MLeggiero/taxelscan/boards/rev4/fab/STACKUP-NOTES.txt

Stackup the design assumes

  4 layer, 1.6 mm finished thickness
  F.Cu / B.Cu   1 oz (35 um)
  In1.Cu        0.5 oz (17.5 um)   GND plane
  In2.Cu        0.5 oz (17.5 um)   +3.3V plane (no signal routing)

The 5 V rails (+5V_BUS, +5V_USB) run only on the 1 oz outer layers,
0.30 mm wide (USB_BUS_SW 0.40 mm): about 1 A at a 10 C rise against
the 0.7 A the chain can draw at the switch's high current limit.
Nothing on In2 carries 5 V, so 0.5 oz inner copper is enough; 1 oz
inner layers are margin, not a problem.

Vias are 0.3 mm drill / 0.5 or 0.6 mm pad: a 0.10 mm annular ring,
inside JLCPCB's via rule (pad >= hole + 0.10 mm) at no extra cost.

The vias are tented: solder mask covers each one on both sides, except
where it sits in a pad's opening. No via hole is in an SMD pad's
solder-mask opening, or within 0.10 mm of one (JLCPCB's minimum mask
bridge), except the 9 ground vias in the exposed pads of U9 (7) and
U12 (2), where the RP2350 and TPS62162 layouts put them, under the
paste windows. U5 pin 15's ground via (that mux's enable, tied low) is
boxed in by the column lines at the toe of its pad, so that pad's toe
is cut back 0.30 mm (1.60 mm long, the other pins 1.90): the hole is
0.15 mm clear of it, under the mask, and the lead still lands on the
pad at the package's largest lead span. tools/via_in_pad.py counts
them, and the board rule 'via hole clear of SMD pads' holds the rest
in KiCad's DRC. Until the 21 October design review 98 vias besides the
exposed pads' had their holes in pads, 32 of them on one pad of a
two-pad passive (the tombstoning case), and the board had to be
ordered with epoxy-filled, capped vias (../REVIEW.md).

Epoxy filled and capped vias are now optional (a paid option on a
4-layer board). They keep paste from draining into the exposed-pad
vias, which otherwise leave some voiding under U9 and U12, as any open
thermal via does. Without them, check the exposed pads at inspection.

Copper is at least 0.40 mm from the outline everywhere: JLCPCB's figure
for a V-scored edge (a routed edge needs 0.2 mm).
