MLeggiero/taxelscan/assets/taxelscan-demo.gif

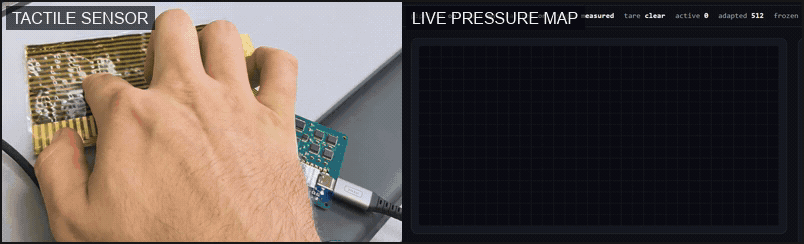
assets/taxelscan-demo.gif
