MLeggiero/taxelscan/assets/taxelscan-v3-bottom.png

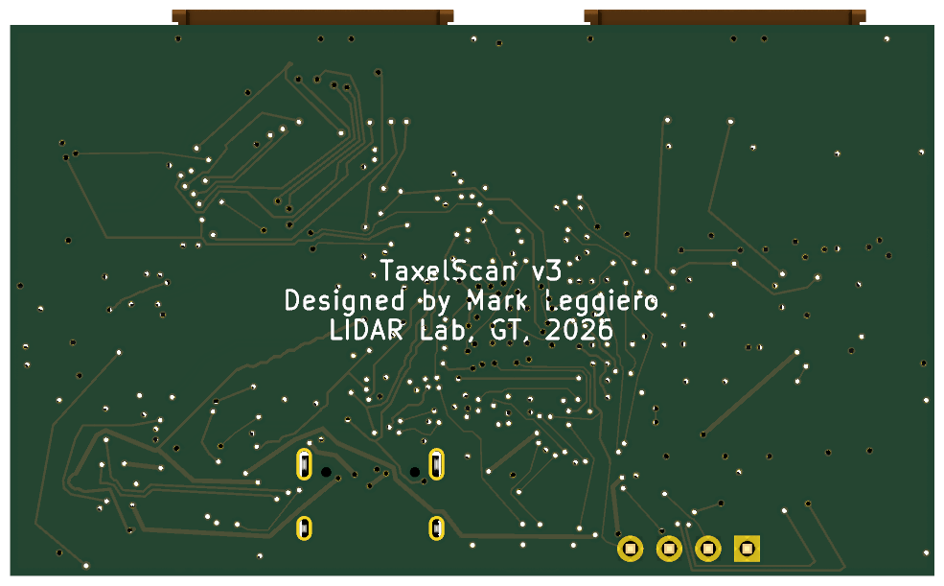
assets/taxelscan-v3-bottom.png
