MLeggiero/taxelscan/assets/taxelscan-v3-top.png

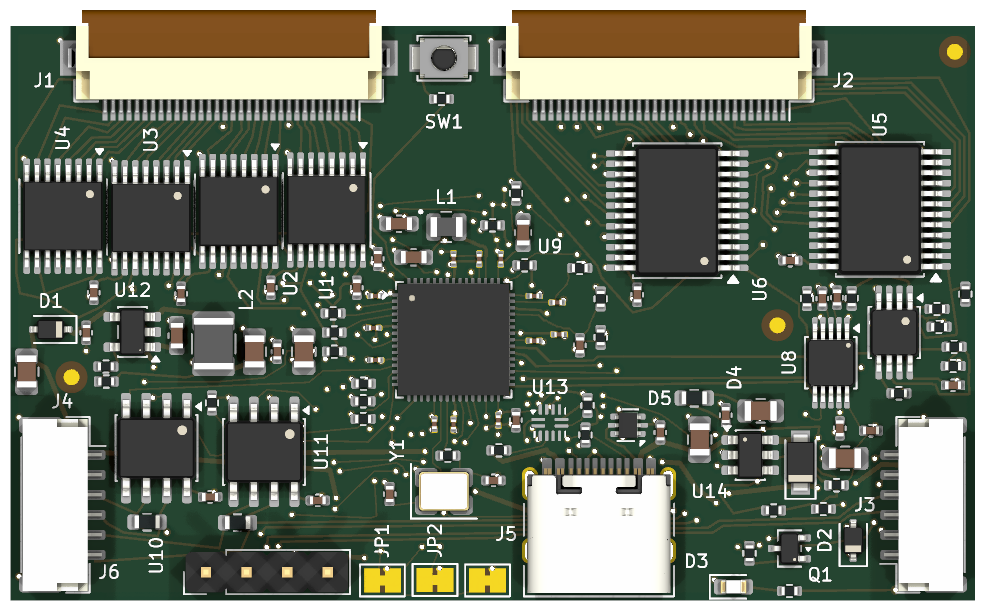
assets/taxelscan-v3-top.png
