MLeggiero/taxelscan/boards/fork-adapter/fork_bottom.png

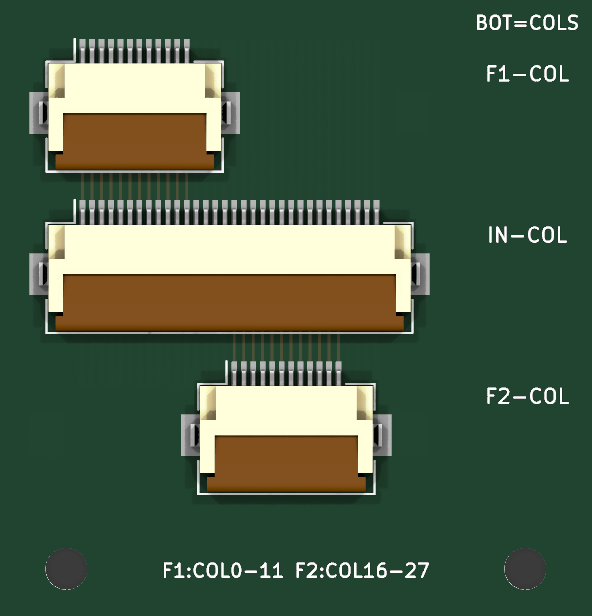
boards/fork-adapter/fork_bottom.png
