MLeggiero/taxelscan/boards/fork-adapter/fork_render.png

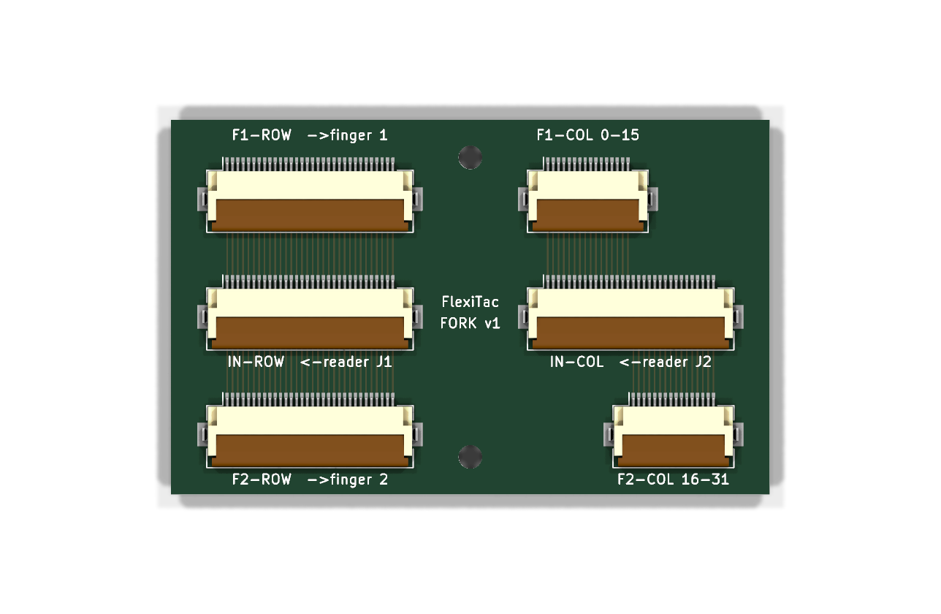
boards/fork-adapter/fork_render.png
