MLeggiero/taxelscan/boards/fork-adapter/fork_top.png

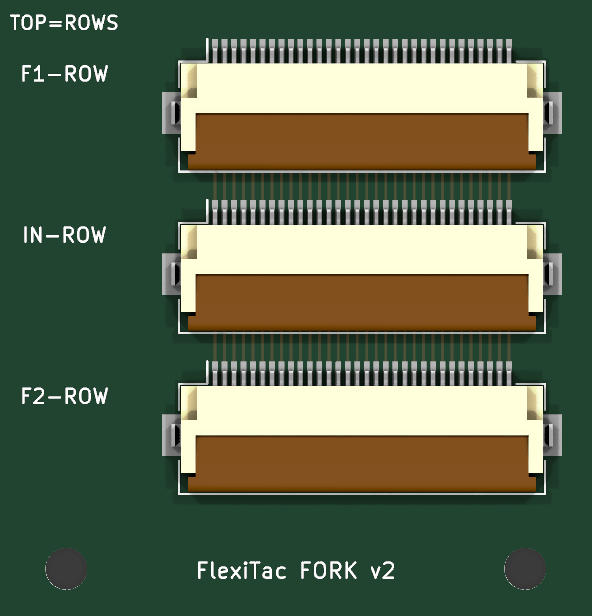
boards/fork-adapter/fork_top.png
