MLeggiero/taxelscan/boards/fork-adapter/fork_v3.png

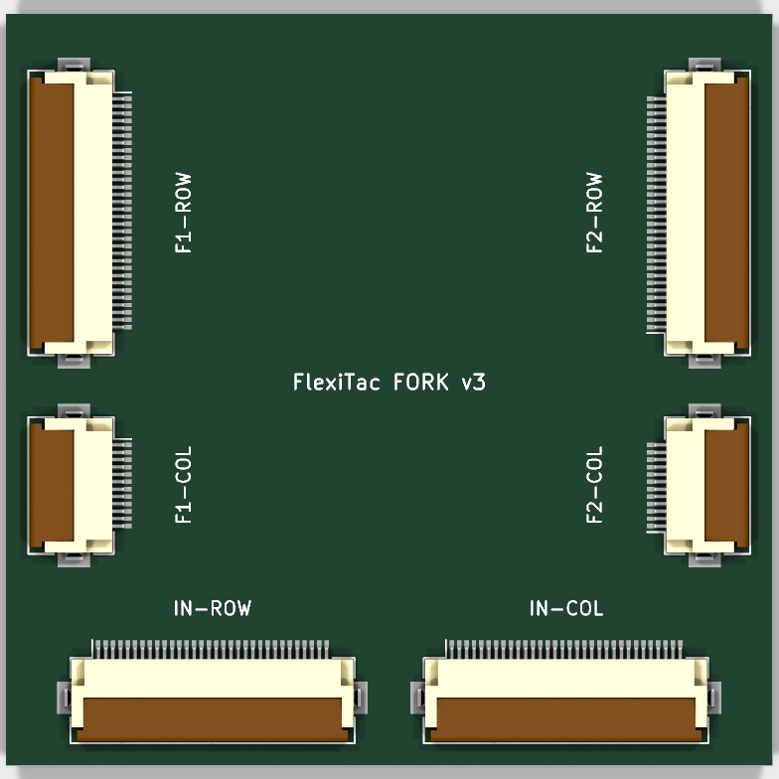
boards/fork-adapter/fork_v3.png
