MLeggiero/taxelscan/boards/fork-adapter/v4_bot.png

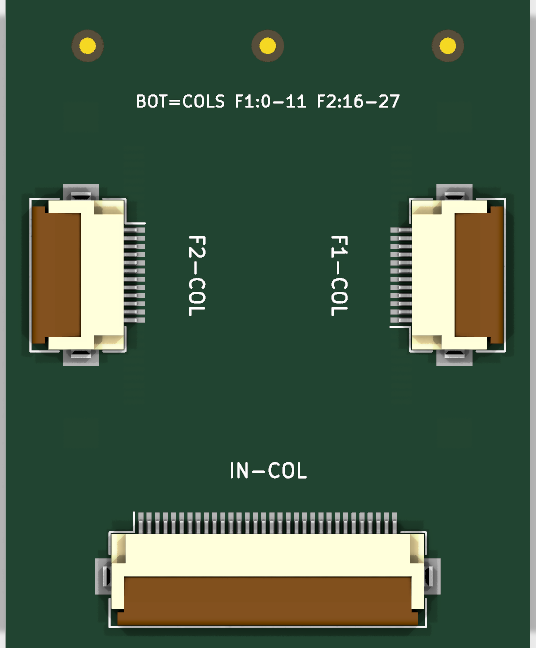
boards/fork-adapter/v4_bot.png
