MLeggiero/taxelscan/boards/fork-adapter/v4_top.png

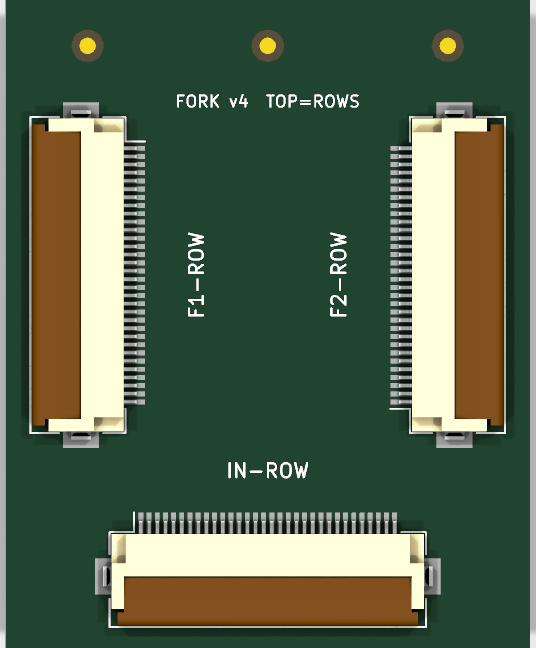
boards/fork-adapter/v4_top.png
