MLeggiero/taxelscan/boards/rev4/pcb_rev3_vs_rev4.png

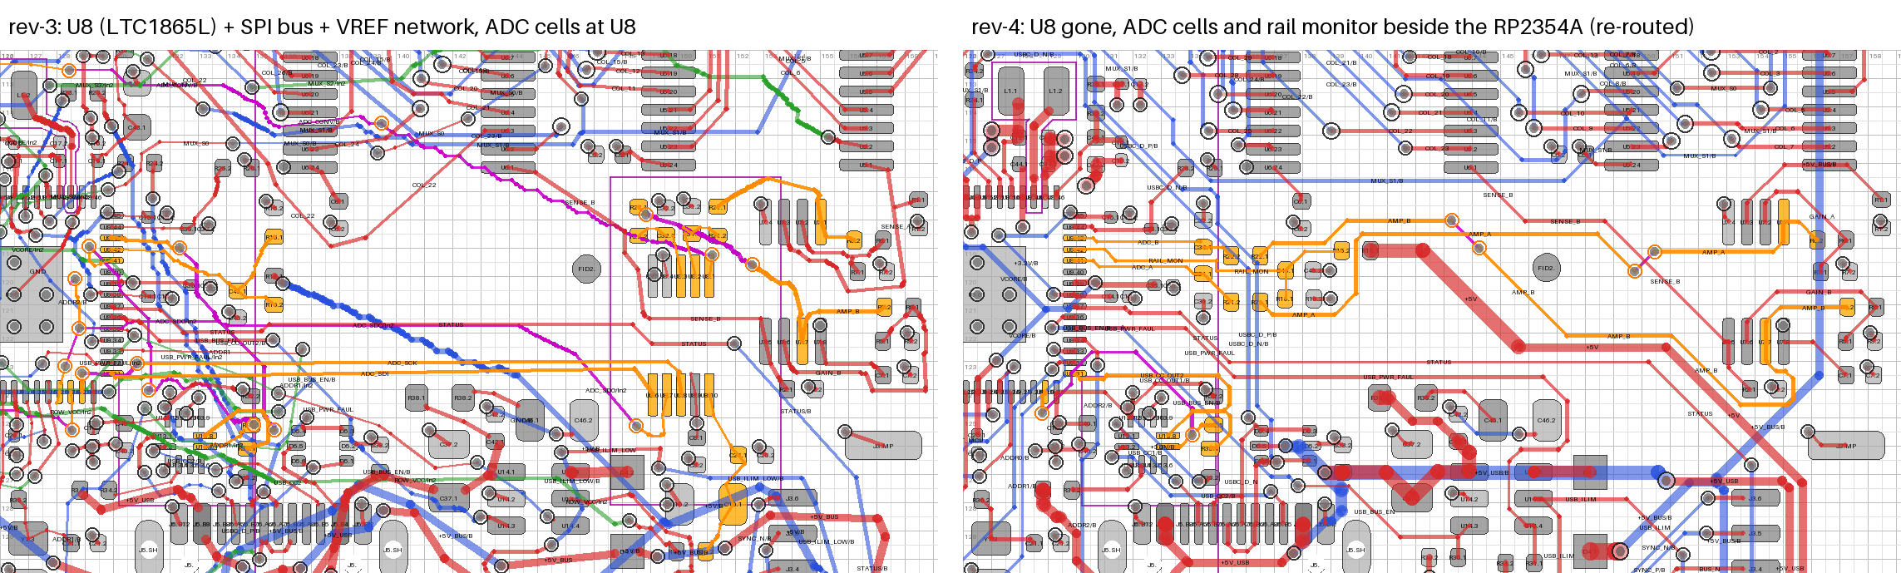
boards/rev4/pcb_rev3_vs_rev4.png
