MLeggiero/taxelscan/boards/rev4/pcb_top.png

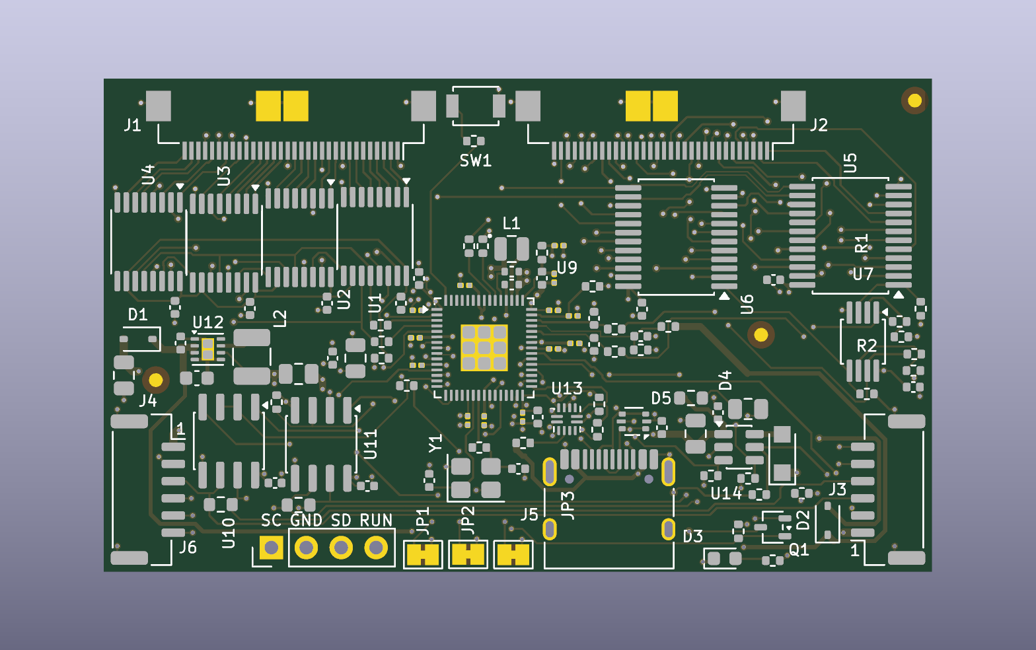
boards/rev4/pcb_top.png
