MLeggiero/taxelscan/boards/v2-module/pcb_top.png

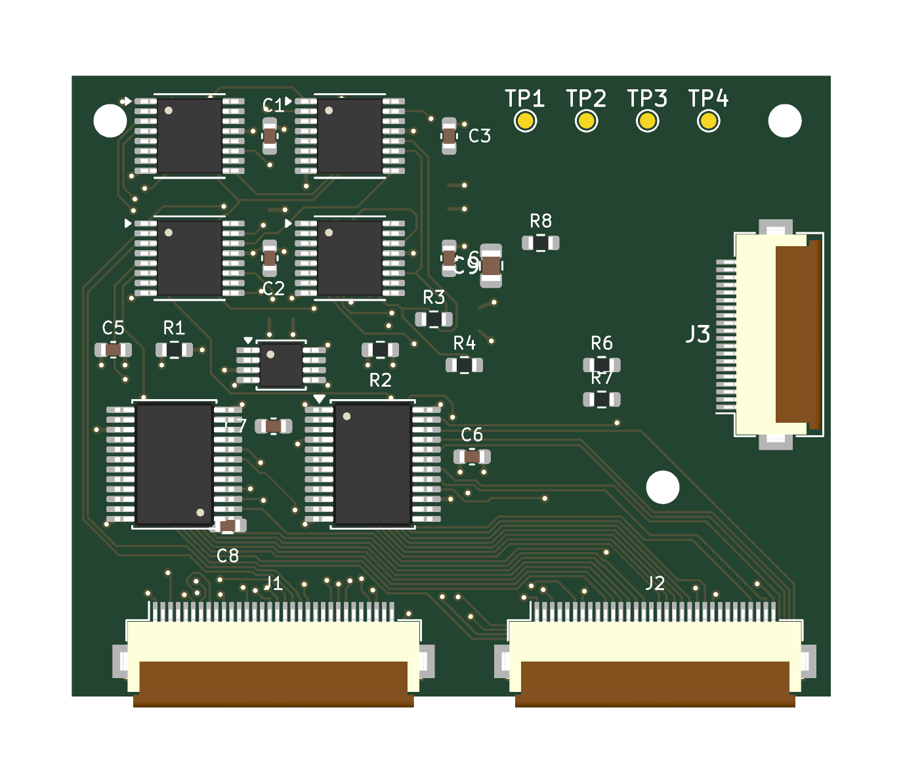
boards/v2-module/pcb_top.png
