MLeggiero/taxelscan/boards/rev4/fab/ORDER-NOTES.txt

JLCPCB order settings for rev-4 (rev-3's, checked 17 September 2026, less U8/C8/R10/C10/C26)

PCB
  Layers 4, thickness 1.6 mm, stackup JLC04161H-7628 (inner 0.5 oz)
  Outer copper 1 oz; via 0.3 mm / 0.45 mm or larger (no surcharge)
  Via Covering: Tented (Epoxy Filled & Capped optional: see STACKUP-NOTES)
  Min trace/space 0.10 mm (above the 3.5 mil surcharge band)

Files
  PCB: rev4-gerbers.zip (Gerbers with Protel extensions, Excellon drills).
  JLCPCB's viewer should show the four copper layers in this order:
    L1 top      rev4-F_Cu.gtl
    L2 ground   rev4-GND.g1   (In1, the GND plane)
    L3 3.3 V    rev4-PWR.g2   (In2, the +3.3V plane)
    L4 bottom   rev4-B_Cu.gbl
  G1 / G2 are Protel's first and second inner layers, and each file
  names its layer in its X2 attributes too. If the viewer has the
  inner layers the other way round, put them right before ordering.

Assembly
  Standard PCBA (0201 parts; Economic stops at 0402), top side only
  Middle boards: rev4-bom.csv + rev4-cpl.csv (no R11/R12)
  The two end boards: rev4-bom-end.csv + rev4-cpl-end.csv
  JLCPCB adds rails; J1/J2 overhang the top edge by 1.5 mm, so expect
  an SMT fixture fee. J6 is through-hole (or leave it for hand fit).

Rotations and positions in the CPLs are already corrected for JLCPCB's
own footprints (jlc_placement.csv, fitted pad by pad by
tools/jlc_placement.py from each LCSC part's EasyEDA footprint):
  turned -90 deg  U1-U4 (TSSOP-16), U5/U6 (SSOP-24), U7 (MSOP-8),
                  U10/U11 (SOIC-8), J6 (pin header, also moved 3.81 mm
                  from pin 1 to its middle)
  turned 180 deg  U14 (SOT-23-6), D5 (SOT-666), Q1 (SOT-323)
  moved           J5 1.57 mm, J1/J2 0.23 mm, J3/J4 0.10 mm (origin offsets)
  unchanged       everything else, U9 / U12 / U13 / Y1 and the diodes and
                  LED included (pad 1 is the cathode in both libraries)
In the preview every part should now sit on its pads with pin 1 on pin 1.
If one does not, fix that part in JLCPCB's editor and tell us which:
its LCSC footprint has changed, and jlc_placement.py must be run again.

Check in the placement preview before confirming
  L1: the polarity dot must sit on pad 1, the VCORE end - the west end,
      over COUT (C19) - per the RP2350 datasheet section 6.3.8.
  C44 / C19 (CIN / COUT, 0402 4.7 uF): centred on their wide-gap pads,
      VREG_LX runs between the pads; a part off-centre bridges it.
  U12 (TPS62162, WSON-8 2 x 2 mm): pin 1 (PGND) top left, beside C27;
      the exposed pad must be soldered (two vias in it).
  U9, U12, U14: their pin-1 marks touch neighbouring pads and may be
      clipped from the silkscreen; check pin 1 against the Fab drawing.
  D1-D5, D3 (LED), Q1, U1-U7, U10, U11, U13, Y1: pin 1 / cathode.
  D5 (USBLC6-2P6, SOT-666): pin 1 is the corner nearest J5's D+ pads;
      pins 1/6 carry D+, 3/4 D-, 5 VBUS, 2 GND - a wrong turn shorts
      D+ to VBUS.

JLCPCB assembly stock on 28 October 2026, every BOM line, parts per board
in brackets:
  U9 C41378174 RP2354A: 0 (1); JLCPCB offers 92 for pre-order (8 minimum).
      <- BLOCKS EVERY BOARD. Pre-order it into your JLCPCB parts inventory
      before ordering, or take it through Global Sourcing: Digi-Key had the
      A4 stepping (Raspberry Pi SC1511-A4) on 28 October, 2,740 on 7-inch
      reels and 9,197 on 13-inch. A pre-order does not say its stepping;
      A4 is the current one (bring-up item 7 reads it off the chip).
  L1 C42411119 AOTA-B201610S3R3-101-T: 0 (1), none for pre-order.
      <- BLOCKS EVERY BOARD. It is the RP2350 datasheet's polarity-marked
      inductor (gen_rev4.py asserts it): take it through Global Sourcing
      (Digi-Key had 5,266 on 28 October; 9-15 days), or buy it and consign
      it, or leave L1 off and fit it by hand, dot on pad 1, the VCORE end.
      No L1, no core rail: the RP2354A will not run. If it cannot be had,
      FTC201610S3R3MBCA (C5832345) fits L1's pads and meets the datasheet's
      numbers but has no polarity mark, so about half the boards would get
      it the wrong way round: scope VCORE under load on each and turn L1
      round on those that misbehave.
  J1/J2 C597985 FH12-32S-0.5SH(55): 15 (2) = 7 boards.
  J6 C5184785 2.54 mm header: 14 (1) = 14 boards.
  Every other line has stock for at least 260 boards. Re-check on the
  order day.

Harness cables (not part of the PCBA order)
  JST GH: GHR-06V-S housing at each end, SSHL-002T-P0.2 contacts, 26 AWG.
  Wired PIN n TO PIN n: J3 of one board to J4 of the next. J3 and J4 are
  the same part turned 180 degrees, so the wires cross between adjacent
  boards; a cable laid straight across joins pin 1 to pin 6 and puts
  +5V_BUS on SYNC_N. Twist 3 with 4 (BUS_P / BUS_N) and 5 with 6
  (SYNC_P / SYNC_N). Pin 1 (+5V_BUS) is marked '1' on the silkscreen at
  both connectors; ring J3.1 to J4.1 before connecting power.
