MLeggiero/taxelscan/boards/rev4/fab/rev4-assembly-top.pdf

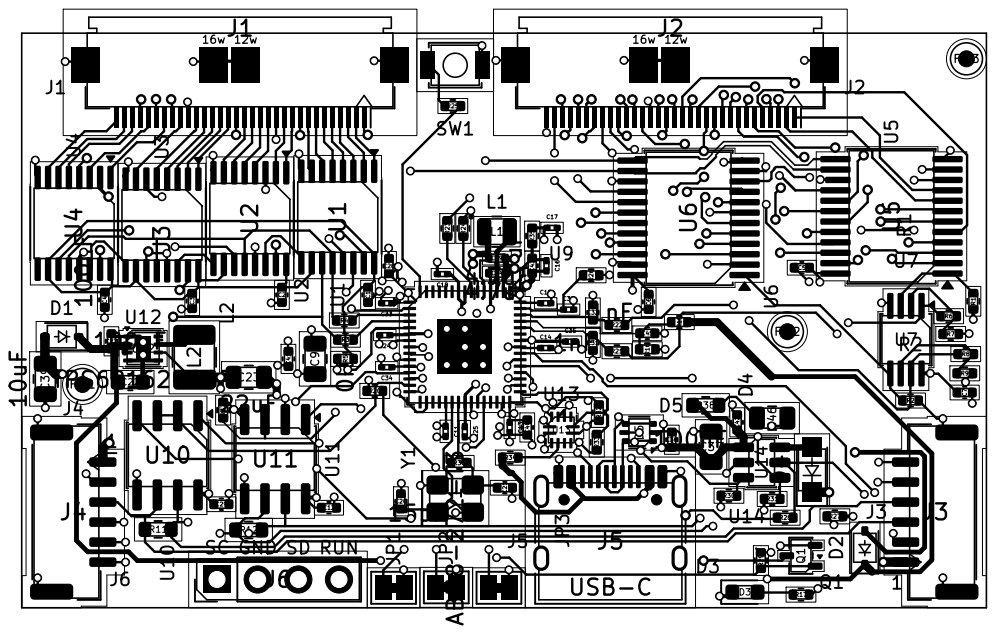
[picture p17: page 1]

SC GND SD RUN

Size: A4 | Rev:
KiCad E.D.A. 10.0.7 | Id: 1/1
