MLeggiero/taxelscan/boards/rev4/fab/rev4-schematic.pdf

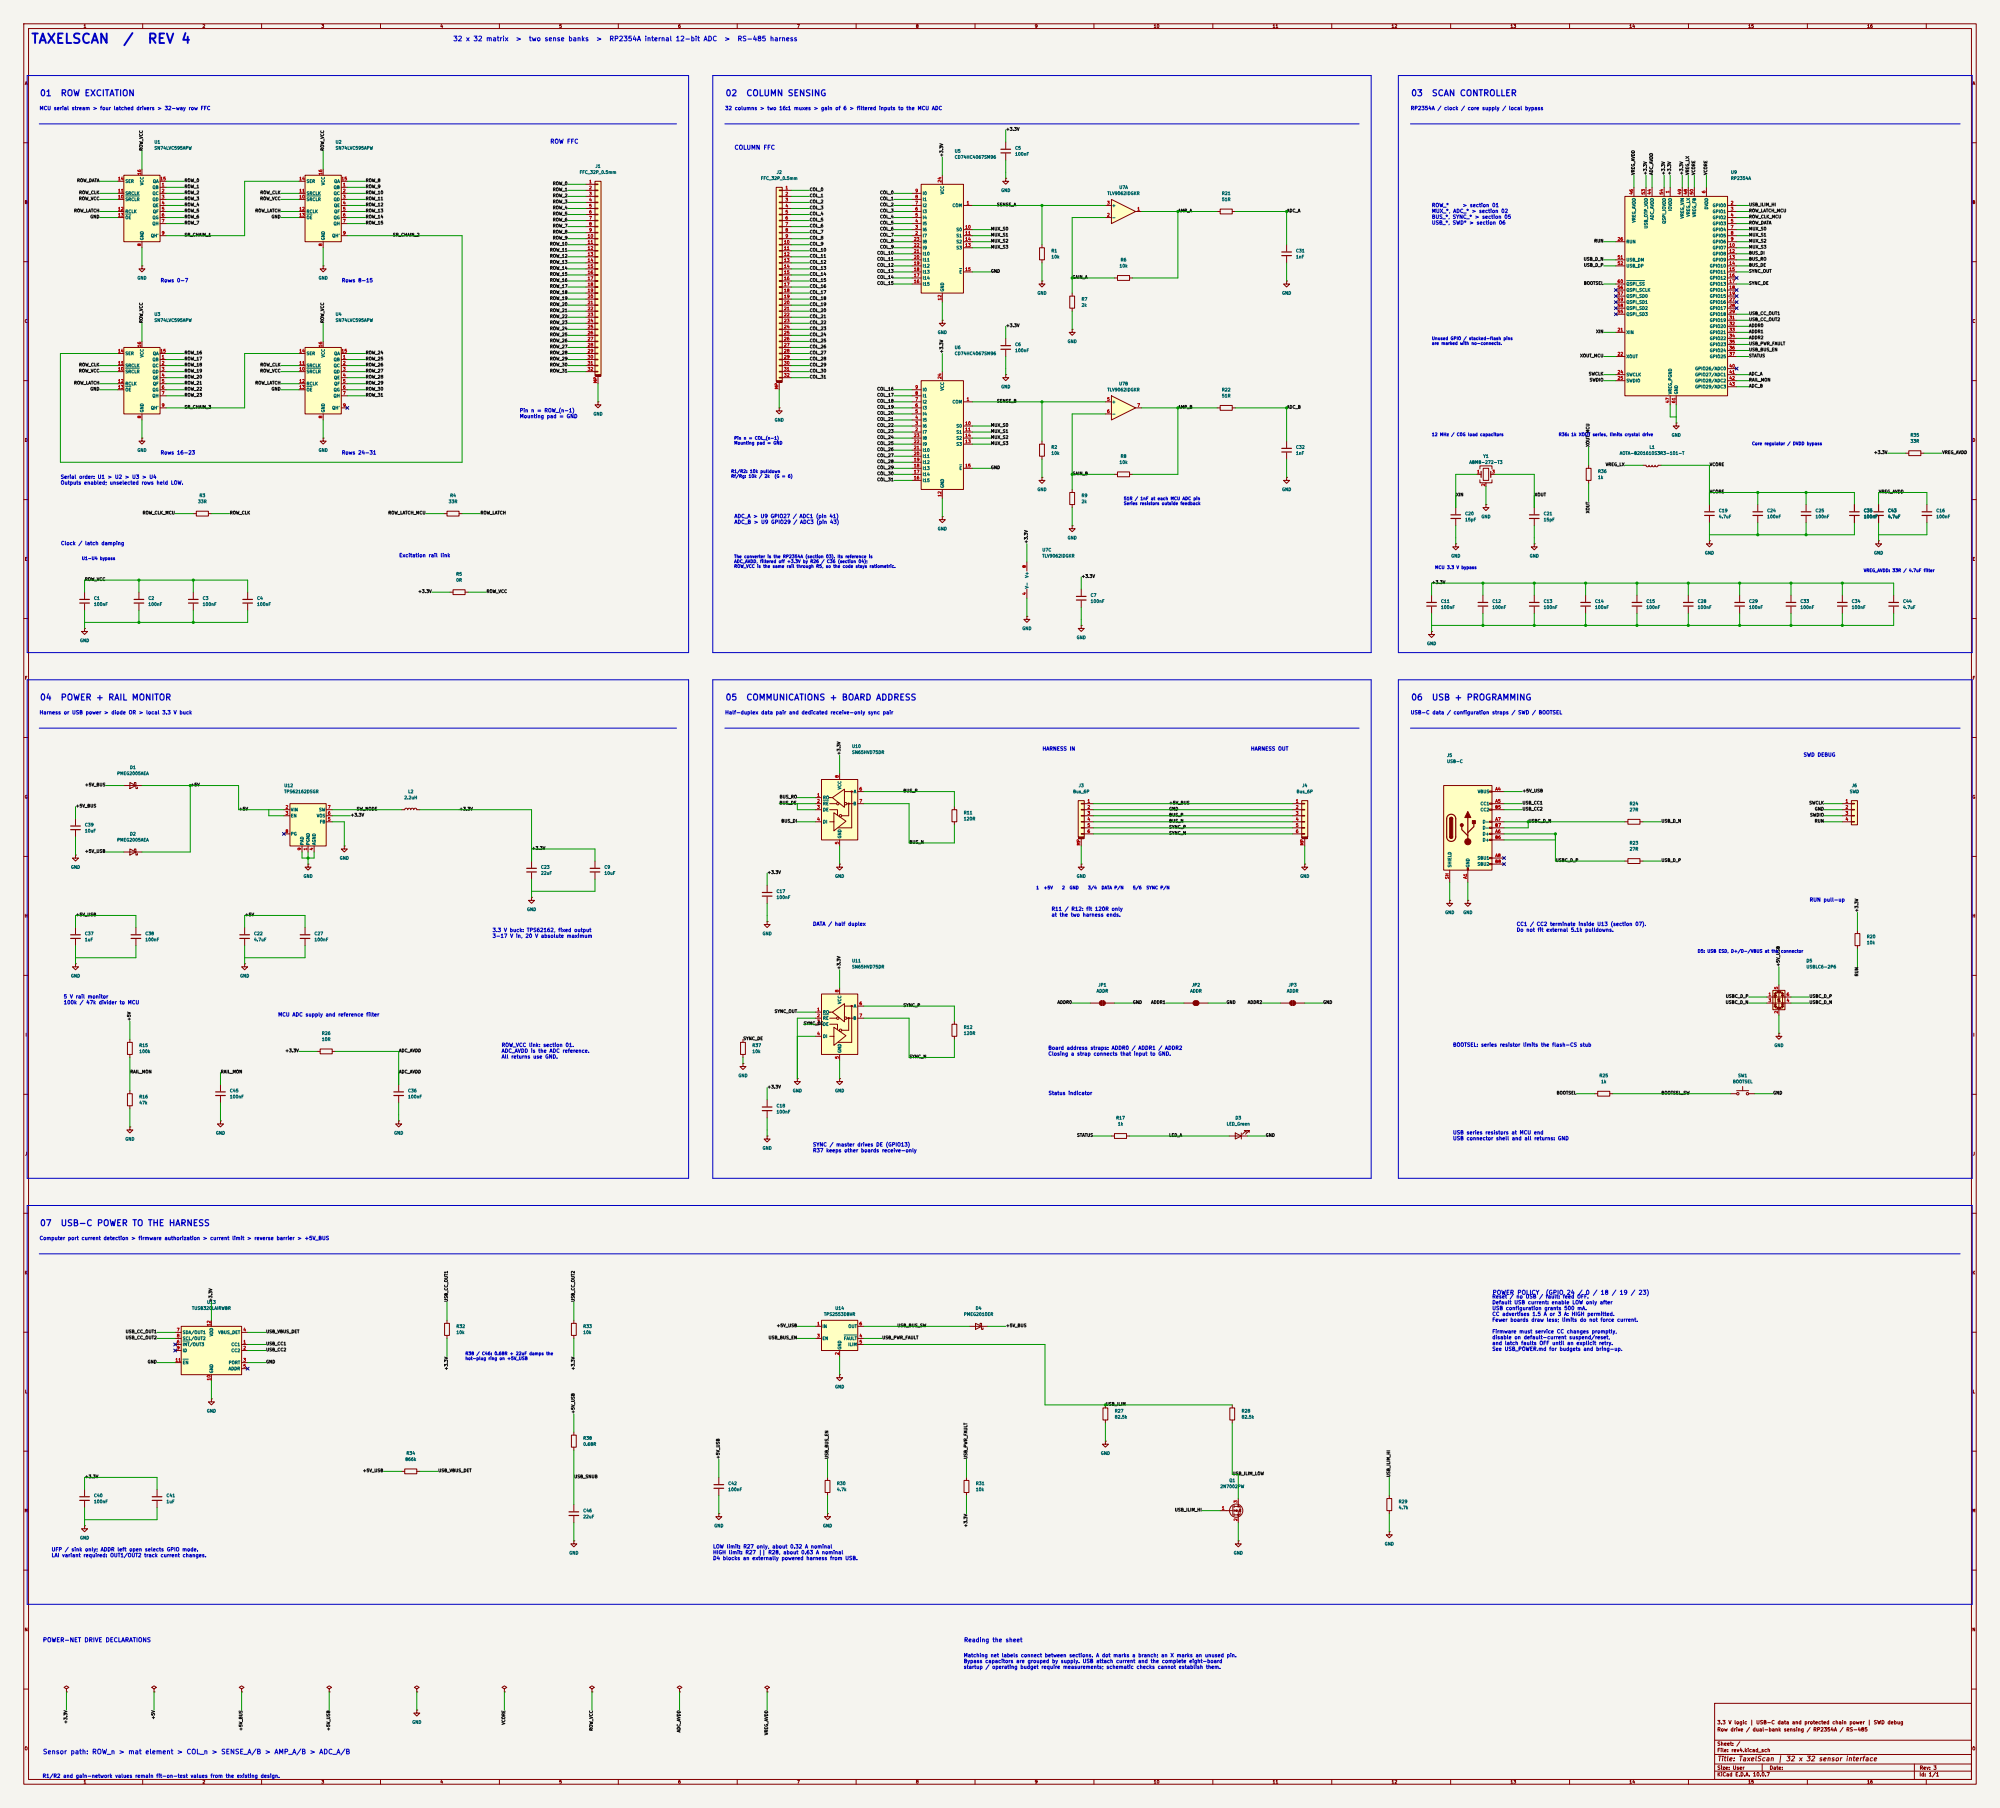
[picture p18: page 1]

32 x 32 matrix > two sense banks > RP2354A internal 12-bit ADC > RS-485 harness

MCU serial stream > four latched drivers > 32-way row FFC

32 columns > two 16:1 muxes > gain of 6 > filtered inputs to the MCU ADC

RP2354A / clock / core supply / local bypass

SRCLR 10 SRCLK 11 RCLK 12 OE 13

Unused GPIO / stacked-flash pins are marked with no-connects.

Core regulator / DVDD bypass 12 MHz / C0G load capacitors

R36: 1k XOUT series, limits crystal drive

The converter is the RP2354A (section 03). Its reference is ADC_AVDD, filtered off +3.3V by R26 / C36 (section 04); ROW_VCC is the same rail through R5, so the code stays ratiometric. R1/R2: 10k pulldown

Serial order: U1 > U2 > U3 > U4
Outputs enabled; unselected rows held LOW.

51R / 1nF at each MCU ADC pin Series resistors outside feedback Excitation rail link

Harness or USB power > diode OR > local 3.3 V buck

Half-duplex data pair and dedicated receive-only sync pair

USB-C data / configuration straps / SWD / BOOTSEL

CC1 / CC2 terminate inside U13 (section 07).
Do not fit external 5.1k pulldowns.

MCU ADC supply and reference filter

ADC_AVDD is the ADC reference.
All returns use GND.

Board address straps: ADDR0 / ADDR1 / ADDR2
Closing a strap connects that input to GND.

USB series resistors at MCU end
USB connector shell and all returns: GND

R37 keeps other boards receive-only

07 USB-C POWER TO THE HARNESS

POWER POLICY (GPIO 24 / 0 / 18 / 19 / 23)
Reset / no USB / fault: feed OFF.
Default USB current: enable LOW only after
USB configuration grants 500 mA.
CC advertises 1.5 A or 3 A: HIGH permitted.
Fewer boards draw less; limits do not force current.

Firmware must service CC changes promptly,
disable on default-current suspend/reset,
and latch faults OFF until an explicit retry.
See USB_POWER.md for budgets and bring-up.

UFP / sink only; ADDR left open selects GPIO mode.
LAI variant required: OUT1/OUT2 track current changes.

LOW limit: R27 only, about 0.32 A nominal
HIGH limit: R27 || R28, about 0.63 A nominal
D4 blocks an externally powered harness from USB.

POWER-NET DRIVE DECLARATIONS

Matching net labels connect between sections. A dot marks a branch; an X marks an unused pin.
Bypass capacitors are grouped by supply. USB attach current and the complete eight-board
startup / operating budget require measurements; schematic checks cannot establish them.

3.3 V logic | USB-C data and protected chain power | SWD debug
Row drive / dual-bank sensing / RP2354A / RS-485

Sheet: /
File: rev4.kicad_sch
Title: TaxelScan | 32 x 32 sensor interface

Sensor path: ROW_n > mat element > COL_n > SENSE_A/B > AMP_A/B > ADC_A/B

Size: User | Rev: 3
KiCad E.D.A. 10.0.7 | Id: 1/1

R1/R2 and gain-network values remain fit-on-test values from the existing design.
