MLeggiero/taxelscan/boards/v2-module/module.pdf

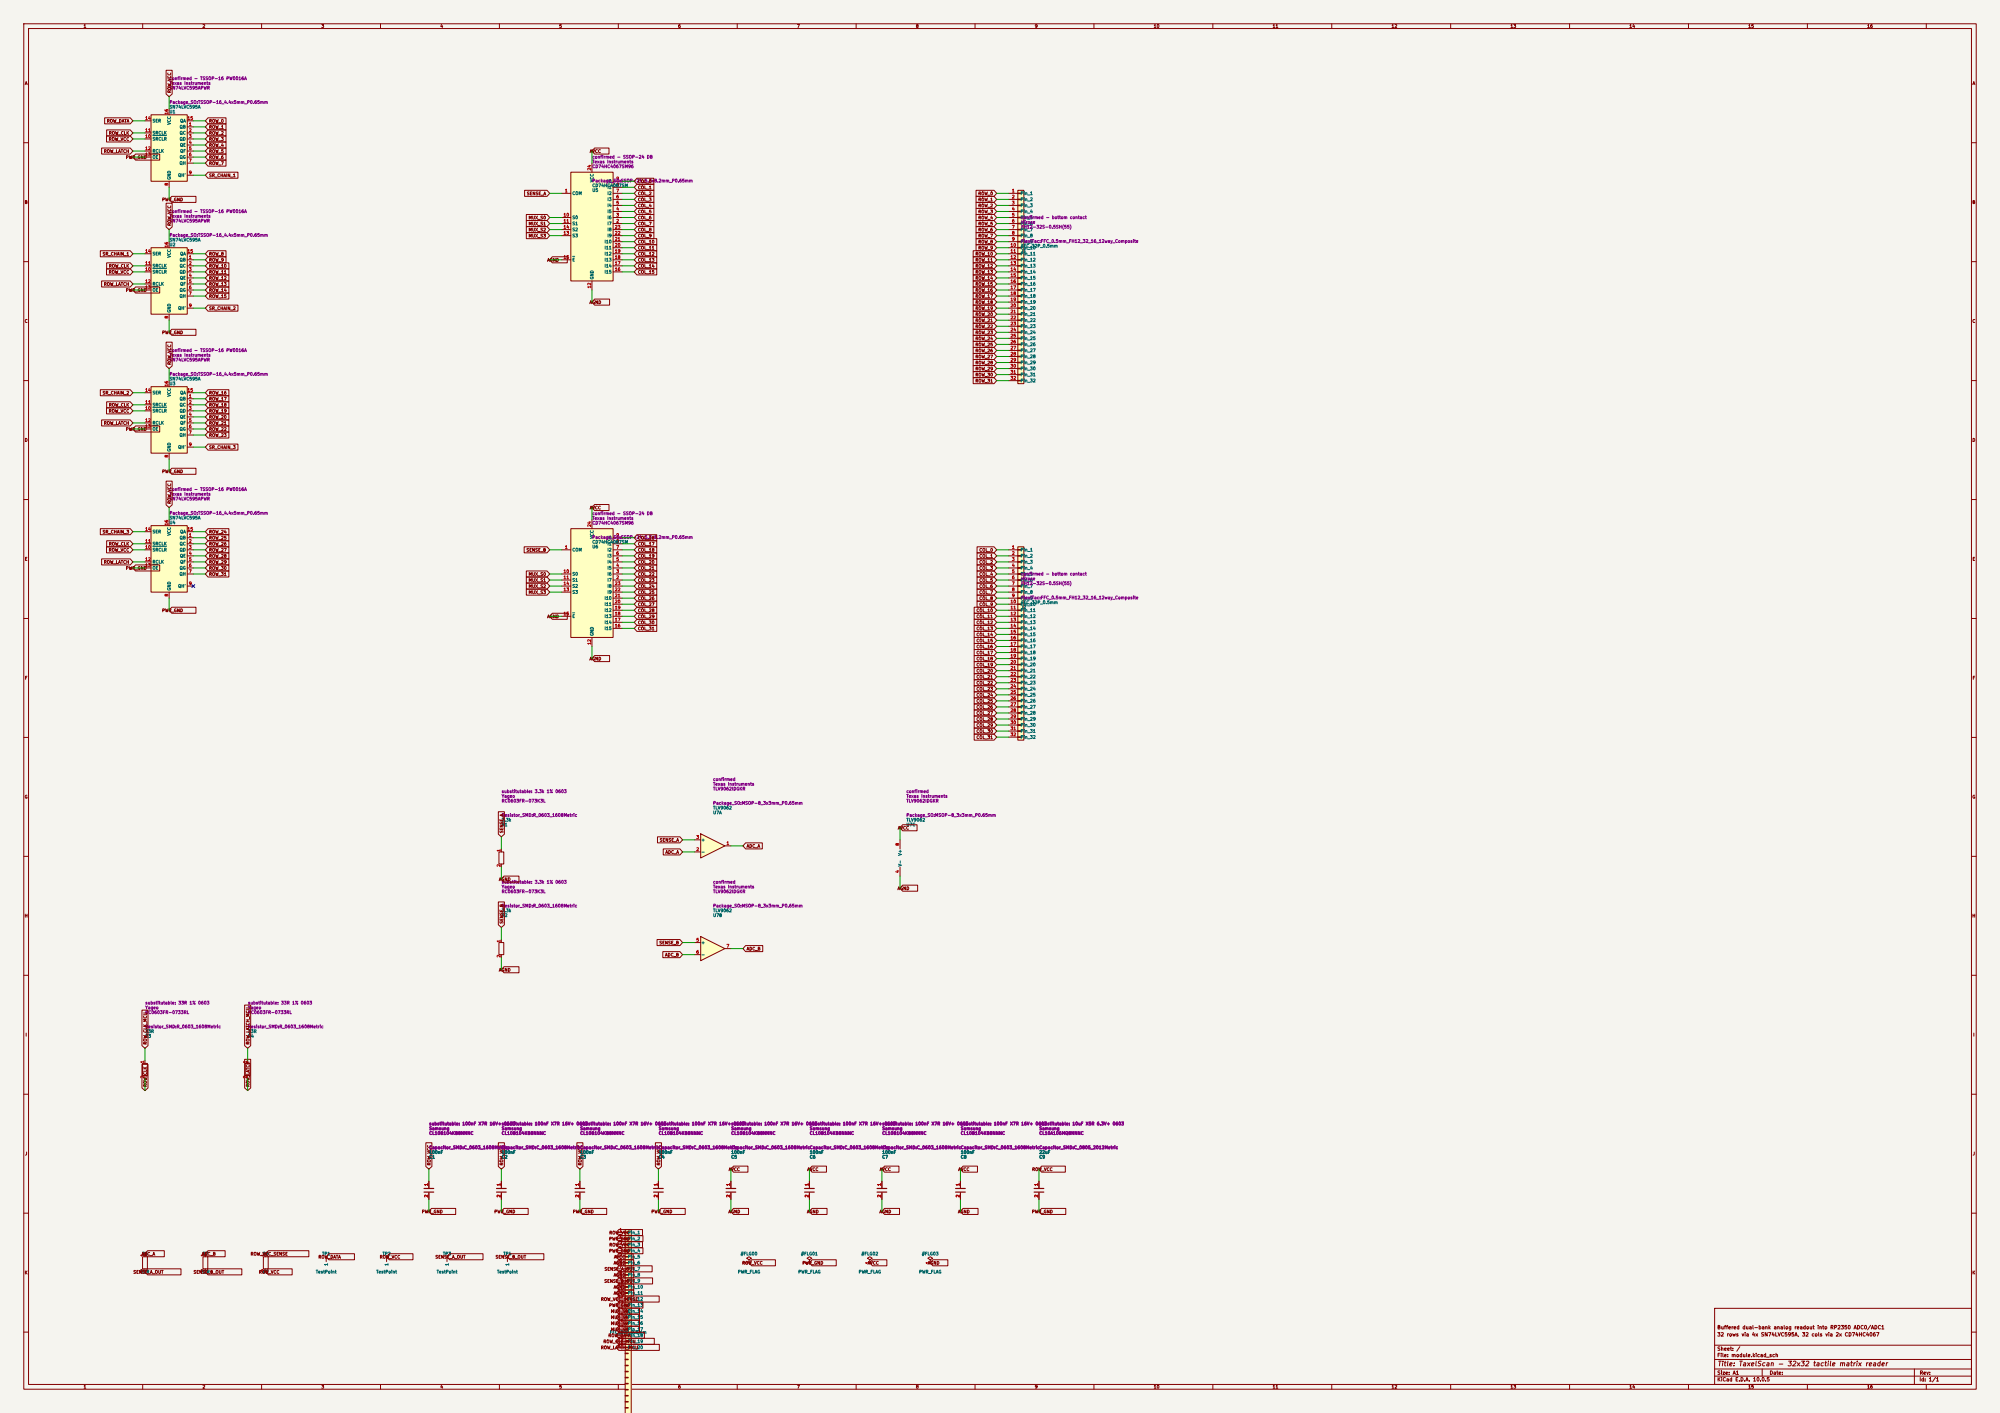
[picture p19: page 1]

SRCLR 10 SRCLK 11 RCLK 12 OE 13

AVCC
Texas Instruments confirmed - SSOP-24 DB

Buffered dual-bank analog readout into RP2350 ADC0/ADC1
32 rows via 4x SN74LVC595A, 32 cols via 2x CD74HC4067

Sheet: /
File: module.kicad_sch
Title: TaxelScan - 32x32 tactile matrix reader

Size: A1 | Rev:
KiCad E.D.A. 10.0.5 | Id: 1/1
