MLeggiero/taxelscan/boards/rev4/fab/rev4-fab-drawing.pdf

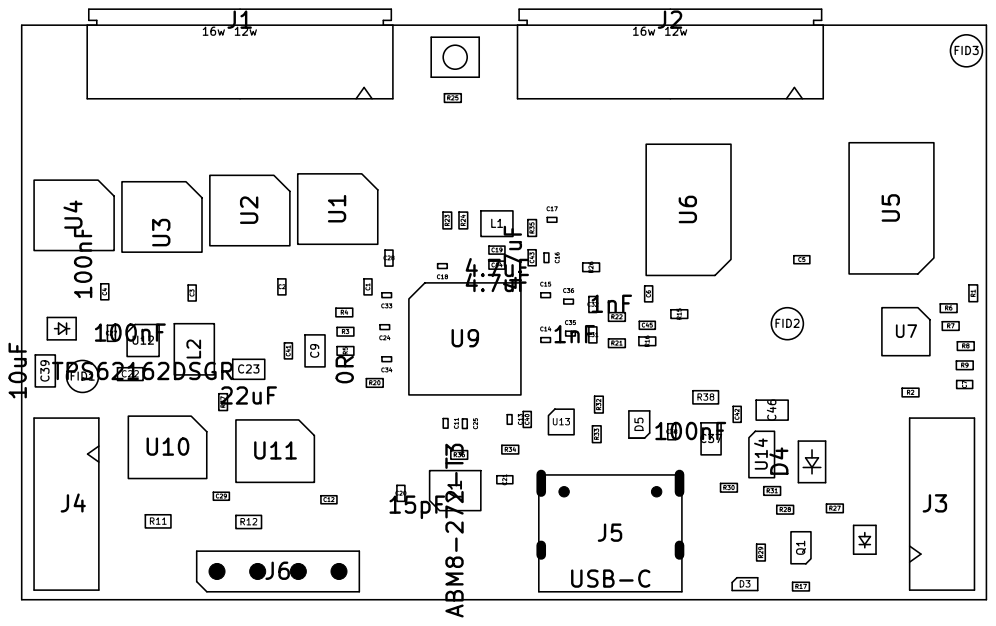
[picture p20: page 1]

Size: A4 | Rev:
KiCad E.D.A. 10.0.7 | Id: 1/1
