MLeggiero/taxelscan/boards/rev1/outputs/taxelscan_Schematic.pdf

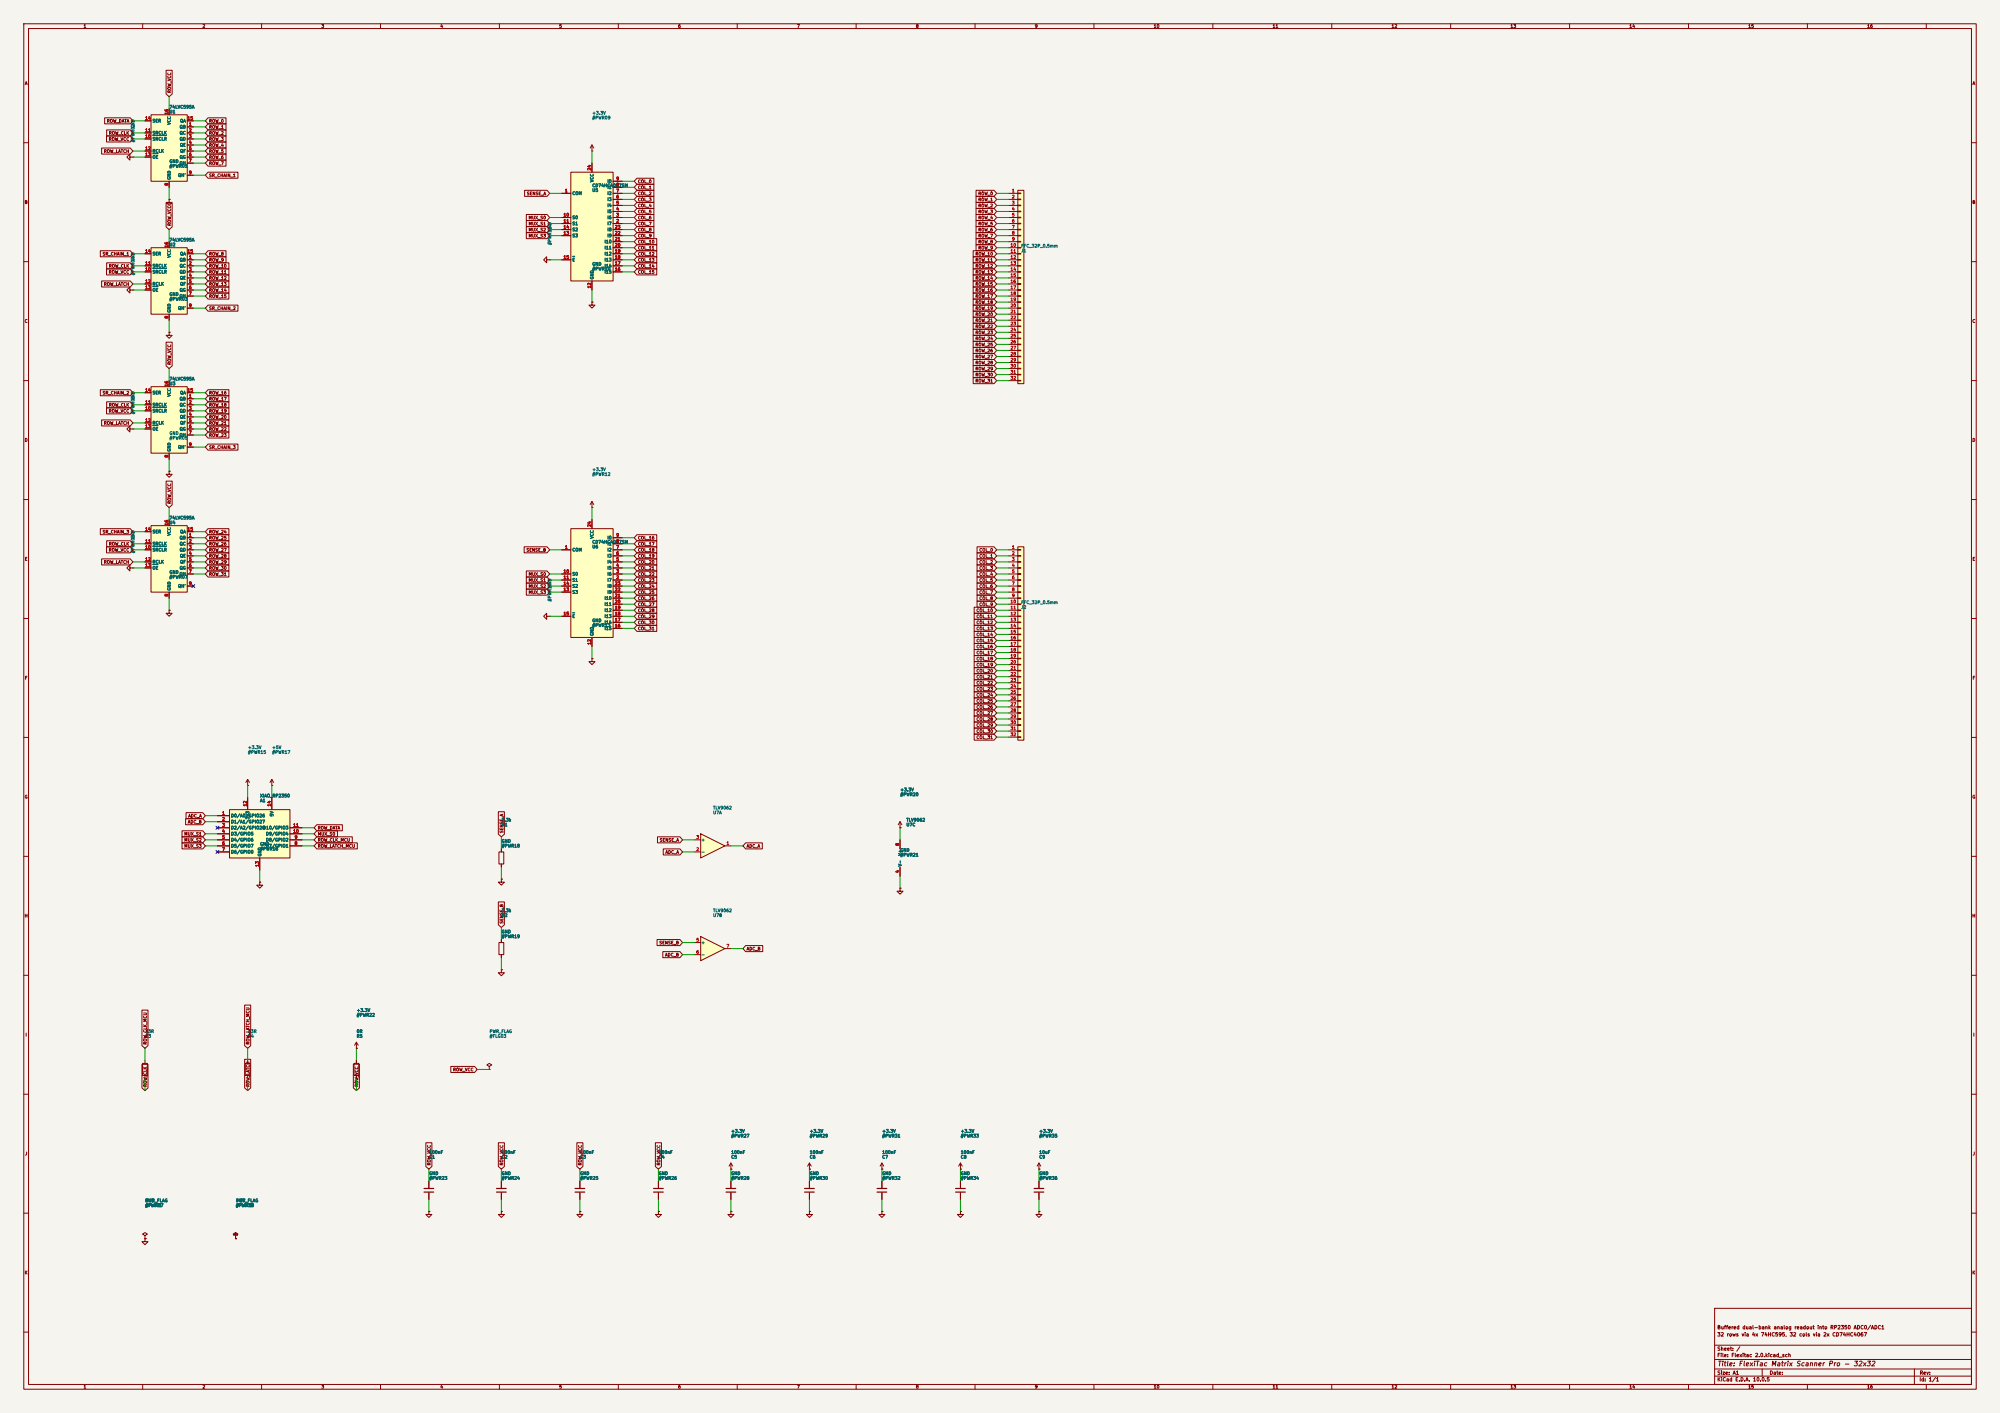
[picture p22: page 1]

SRCLR 10 SRCLK 11 RCLK 12 OE 13
#PWR24 GND #PWR04GND

#PWR05 GND U4

Buffered dual-bank analog readout into RP2350 ADC0/ADC1
32 rows via 4x 74HC595, 32 cols via 2x CD74HC4067

Sheet: /
File: Flexitac 2.0.kicad_sch
Title: FlexiTac Matrix Scanner Pro - 32x32

Size: A1 | Rev:
KiCad E.D.A. 10.0.5 | Id: 1/1
