MLeggiero/taxelscan/boards/rev3/fab/rev3-fab-drawing.pdf

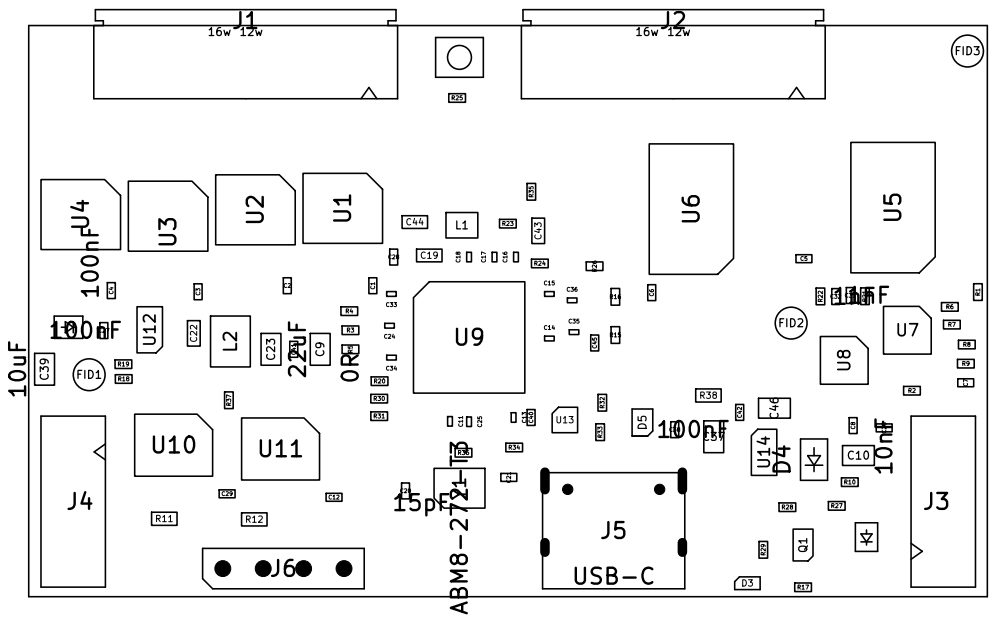
[picture p23: page 1]

Size: A4 | Rev:
KiCad E.D.A. 10.0.5 | Id: 1/1
