MLeggiero/taxelscan/boards/rev1/outputs/taxelscan_FitCheck_1to1.pdf

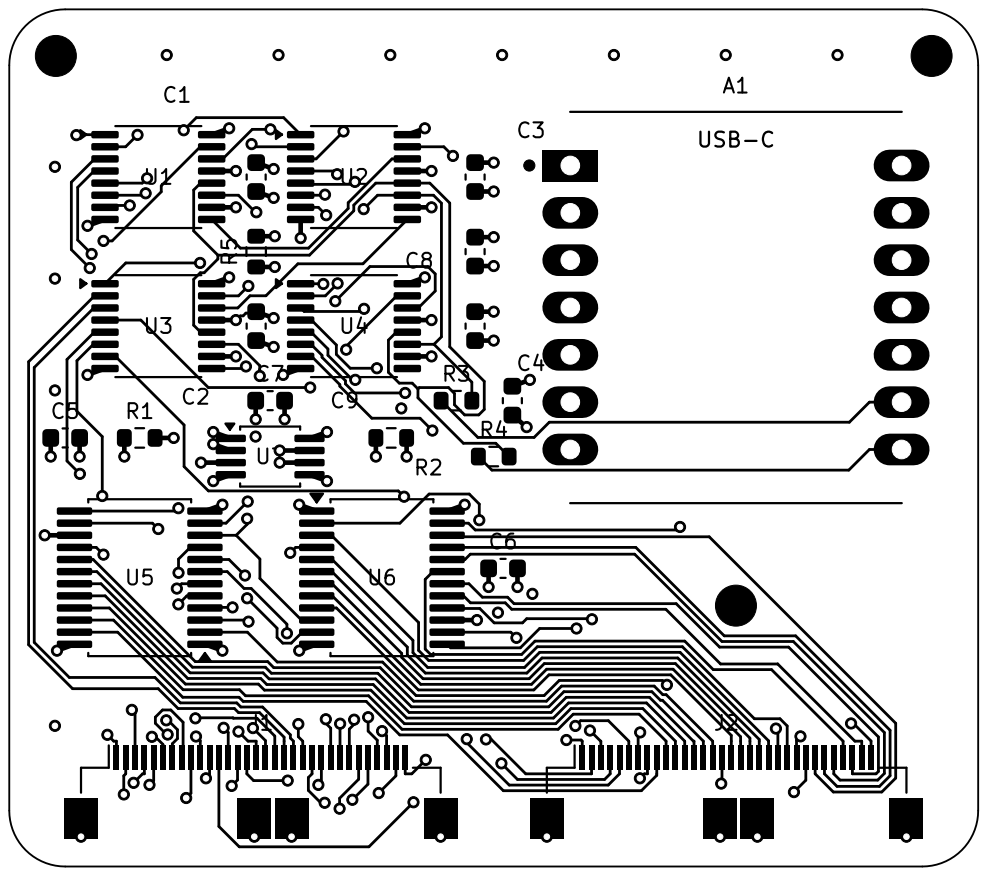
[picture p24: page 1]

Size: USLetter | Rev:
KiCad E.D.A. 10.0.5 | Id: 1/1
