MLeggiero/taxelscan/(list of files, drawings)

Other design files:
boards/fork-adapter/fork-adapter.dsn
boards/rev1/outputs/taxelscan.dsn
