MLeggiero/taxelscan/boards/rev4/rev4.kicad_pcb

## KiCad design boards/rev4/rev4.kicad_pcb (2026-10-26)

Schematic: rev4.kicad_sch, TaxelScan | 32 x 32 sensor interface

Parts:
C1, C2, C3, C4, C5, C6, C7, C12, C27, C28, C29, C38, C40, C42, C45: 100nF; C_0402_1005Metric
C9, C39: 10uF; C_0805_2012Metric
C11, C13, C14, C15, C16, C17, C18, C24, C25, C33, C34, C35, C36: 100nF; C_0201_0603Metric
C19, C44: 4.7uF; C_0402_1005Metric_WideGap
C20, C21: 15pF; C_0402_1005Metric
C22: 4.7uF; C_0603_1608Metric
C23, C46: 22uF; C_0805_2012Metric
C31, C32: 1nF; C_0402_1005Metric
C37: 1uF; C_0805_2012Metric
C41: 1uF; C_0402_1005Metric
C43: 4.7uF; C_0402_1005Metric
D1, D2: PMEG2005AEA; D_SOD-323
D3: LED_Green; LED_0603_1608Metric
D4: PMEG2010ER; Nexperia_CFP3_SOD-123W
D5: USBLC6-2P6; SOT-666
J1, J2: FFC_32P_0.5mm; FFC_0.5mm_FH12_32_16_12way_Composite
J3, J4: Bus_6P; JST_GH_SM06B-GHS-TB_1x06-1MP_P1.25mm_Horizontal
J5: USB-C; USB_C_Receptacle_HRO_TYPE-C-31-M-12
J6: SWD; PinHeader_1x04_P2.54mm_Vertical
JP1, JP2, JP3: ADDR; SolderJumper-2_P1.3mm_Bridged_Pad1.0x1.5mm
L1: AOTA-B201610S3R3-101-T; L_0806_2016Metric
L2: 2.2uH; L_1210_3225Metric
Q1: 2N7002PW; SOT-323_SC-70
R1, R2, R6, R8, R20, R31, R32, R33, R37: 10k; R_0402_1005Metric
R3, R4, R35: 33R; R_0402_1005Metric
R5: 0R; R_0402_1005Metric
R7, R9: 2k; R_0402_1005Metric
R11, R12: 120R; R_0603_1608Metric
R15: 100k; R_0402_1005Metric
R16: 47k; R_0402_1005Metric
R17, R25, R36: 1k; R_0402_1005Metric
R21, R22: 51R; R_0402_1005Metric
R23, R24: 27R; R_0402_1005Metric
R26: 10R; R_0402_1005Metric
R27, R28: 82.5k; R_0402_1005Metric
R29, R30: 4.7k; R_0402_1005Metric
R34: 866k; R_0402_1005Metric
R38: 0.68R; R_0603_1608Metric
SW1: BOOTSEL; SW_SPST_B3U-1000P
U1, U2, U3, U4: SN74LVC595APW; TSSOP-16_4.4x5mm_P0.65mm
U5, U6: CD74HC4067SM96; SSOP-24_5.3x8.2mm_P0.65mm
U7: TLV9062IDGKR; MSOP-8_3x3mm_P0.65mm
U9: RP2354A; QFN-60-1EP_7x7mm_P0.4mm_EP3.4x3.4mm
U10, U11: SN65HVD75DR; SOIC-8_3.9x4.9mm_P1.27mm
U12: TPS62162DSGR; Texas_DSG0008A_WSON-8-1EP_2x2mm_P0.5mm_EP0.9x1.6mm
U13: TUSB320LAIRWBR; Texas_X2QFN-12_1.6x1.6mm_P0.4mm
U14: TPS2553DBVR; SOT-23-6
Y1: ABM8-272-T3; Crystal_SMD_3225-4Pin_3.2x2.5mm

Connections:
+3.3V: C5.1, C6.1, C7.1, C9.1, C11.1, C12.1, C13.1, C14.1, C15.1, C17.1, C18.1, C23.1, C28.1, C29.1, C33.1, C34.1, C40.1, C41.1, C44.1, L2.2, R5.1, R20.2, R26.1, R31.2, R32.2, R33.2, R35.1, U5.24 (VCC), U6.24 (VCC), U7.8 (V+), U9.1 (IOVDD), U9.11 (IOVDD), U9.20 (IOVDD), U9.30 (IOVDD), U9.38 (IOVDD), U9.45 (IOVDD), U9.49 (VREG_VIN), U9.53 (USB_OTP_VDD), U9.54 (QSPI_IOVDD), U10.8 (VCC), U11.8 (VCC), U12.6 (VOS), U13.12 (VDD)
+5V: C22.1, C27.1, D1.1 (K), D2.1 (K), R15.1, U12.2 (VIN), U12.3 (EN)
+5V_BUS: C39.1, D1.2 (A), D4.1 (K), J3.1, J4.1
+5V_USB: C37.1, C38.1, C42.1, D2.2 (A), D5.5 (VBUS), J5.A4 (VBUS), J5.A9 (VBUS), J5.B4 (VBUS), J5.B9 (VBUS), R34.1, R38.1, U14.1 (IN)
ADC_A: C31.1, R21.2, U9.41 (GPIO27/ADC1)
ADC_AVDD: C36.1, R26.2, U9.44 (ADC_AVDD)
ADC_B: C32.1, R22.2, U9.43 (GPIO29/ADC3)
ADDR0: JP1.1 (A), U9.32 (GPIO20)
ADDR1: JP2.1 (A), U9.33 (GPIO21)
ADDR2: JP3.1 (A), U9.34 (GPIO22)
AMP_A: R6.2, R21.1, U7.1
AMP_B: R8.2, R22.1, U7.7
BOOTSEL: R25.1, U9.60 (~QSPI_SS)
BOOTSEL_SW: R25.2, SW1.1
BUS_DE: U9.14 (GPIO10), U10.2 (~RE), U10.3 (DE)
BUS_DI: U9.12 (GPIO8), U10.4 (DI)
BUS_N: J3.4, J4.4, R11.2, U10.7 (B)
BUS_P: J3.3, J4.3, R11.1, U10.6 (A)
BUS_RO: U9.13 (GPIO9), U10.1 (RO)
COL_0: J2.1, U5.9 (I0)
COL_1: J2.2, U5.8 (I1)
COL_2: J2.3, U5.7 (I2)
COL_3: J2.4, U5.6 (I3)
COL_4: J2.5, U5.5 (I4)
COL_5: J2.6, U5.4 (I5)
COL_6: J2.7, U5.3 (I6)
COL_7: J2.8, U5.2 (I7)
COL_8: J2.9, U5.23 (I8)
COL_9: J2.10, U5.22 (I9)
COL_10: J2.11, U5.21 (I10)
COL_11: J2.12, U5.20 (I11)
COL_12: J2.13, U5.19 (I12)
COL_13: J2.14, U5.18 (I13)
COL_14: J2.15, U5.17 (I14)
COL_15: J2.16, U5.16 (I15)
COL_16: J2.17, U6.9 (I0)
COL_17: J2.18, U6.8 (I1)
COL_18: J2.19, U6.7 (I2)
COL_19: J2.20, U6.6 (I3)
COL_20: J2.21, U6.5 (I4)
COL_21: J2.22, U6.4 (I5)
COL_22: J2.23, U6.3 (I6)
COL_23: J2.24, U6.2 (I7)
COL_24: J2.25, U6.23 (I8)
COL_25: J2.26, U6.22 (I9)
COL_26: J2.27, U6.21 (I10)
COL_27: J2.28, U6.20 (I11)
COL_28: J2.29, U6.19 (I12)
COL_29: J2.30, U6.18 (I13)
COL_30: J2.31, U6.17 (I14)
COL_31: J2.32, U6.16 (I15)
GAIN_A: R6.1, R7.1, U7.2 (-)
GAIN_B: R8.1, R9.1, U7.6 (-)
GND: C1.2, C2.2, C3.2, C4.2, C5.2, C6.2, C7.2, C9.2, C11.2, C12.2, C13.2, C14.2, C15.2, C16.2, C17.2, C18.2, C19.2, C20.2, C21.2, C22.2, C23.2, C24.2, C25.2, C27.2, C28.2, C29.2, C31.2, C32.2, C33.2, C34.2, C35.2, C36.2, C37.2, C38.2, C39.2, C40.2, C41.2, C42.2, C43.2, C44.2, C45.2, C46.2, D3.1 (K), D5.2 (GND), J1.MP (MountPin), J2.MP (MountPin), J3.2, J3.MP (MountPin), J4.2, J4.MP (MountPin), J5.A1 (GND), J5.A12 (GND), J5.B1 (GND), J5.B12 (GND), J5.SH (SHIELD), J6.2, JP1.2 (B), JP2.2 (B), JP3.2 (B), Q1.2 (S), R1.2, R2.2, R7.2, R9.2, R16.2, R27.2, R29.2, R30.2, R37.2, SW1.2, U1.8 (GND), U1.13 (~OE), U2.8 (GND), U2.13 (~OE), U3.8 (GND), U3.13 (~OE), U4.8 (GND), U4.13 (~OE), U5.12 (GND), U5.15 (~E), U6.12 (GND), U6.15 (~E), U7.4 (V-), U9.47 (VREG_PGND), U9.61 (GND), U10.5 (GND), U11.2 (~RE), U11.4 (DI), U11.5 (GND), U12.1 (PGND), U12.4 (AGND), U12.5 (FB), U12.9 (PAD), U13.3 (PORT), U13.10 (GND), U13.11 (~EN), U14.2 (GND), Y1.2 (G), Y1.4 (G)
LED_A: D3.2 (A), R17.2
MUX_S0: U5.10 (S0), U6.10 (S0), U9.7 (GPIO4)
MUX_S1: U5.11 (S1), U6.11 (S1), U9.8 (GPIO5)
MUX_S2: U5.14 (S2), U6.14 (S2), U9.9 (GPIO6)
MUX_S3: U5.13 (S3), U6.13 (S3), U9.10 (GPIO7)
RAIL_MON: C45.1, R15.2, R16.1, U9.42 (GPIO28/ADC2)
ROW_0: J1.1, U1.15 (QA)
ROW_1: J1.2, U1.1 (QB)
ROW_2: J1.3, U1.2 (QC)
ROW_3: J1.4, U1.3 (QD)
ROW_4: J1.5, U1.4 (QE)
ROW_5: J1.6, U1.5 (QF)
ROW_6: J1.7, U1.6 (QG)
ROW_7: J1.8, U1.7 (QH)
ROW_8: J1.9, U2.15 (QA)
ROW_9: J1.10, U2.1 (QB)
ROW_10: J1.11, U2.2 (QC)
ROW_11: J1.12, U2.3 (QD)
ROW_12: J1.13, U2.4 (QE)
ROW_13: J1.14, U2.5 (QF)
ROW_14: J1.15, U2.6 (QG)
ROW_15: J1.16, U2.7 (QH)
ROW_16: J1.17, U3.15 (QA)
ROW_17: J1.18, U3.1 (QB)
ROW_18: J1.19, U3.2 (QC)
ROW_19: J1.20, U3.3 (QD)
ROW_20: J1.21, U3.4 (QE)
ROW_21: J1.22, U3.5 (QF)
ROW_22: J1.23, U3.6 (QG)
ROW_23: J1.24, U3.7 (QH)
ROW_24: J1.25, U4.15 (QA)
ROW_25: J1.26, U4.1 (QB)
ROW_26: J1.27, U4.2 (QC)
ROW_27: J1.28, U4.3 (QD)
ROW_28: J1.29, U4.4 (QE)
ROW_29: J1.30, U4.5 (QF)
ROW_30: J1.31, U4.6 (QG)
ROW_31: J1.32, U4.7 (QH)
ROW_CLK: R3.2, U1.11 (SRCLK), U2.11 (SRCLK), U3.11 (SRCLK), U4.11 (SRCLK)
ROW_CLK_MCU: R3.1, U9.4 (GPIO2)
ROW_DATA: U1.14 (SER), U9.5 (GPIO3)
ROW_LATCH: R4.2, U1.12 (RCLK), U2.12 (RCLK), U3.12 (RCLK), U4.12 (RCLK)
ROW_LATCH_MCU: R4.1, U9.3 (GPIO1)
ROW_VCC: C1.1, C2.1, C3.1, C4.1, R5.2, U1.10 (~SRCLR), U1.16 (VCC), U2.10 (~SRCLR), U2.16 (VCC), U3.10 (~SRCLR), U3.16 (VCC), U4.10 (~SRCLR), U4.16 (VCC)
RUN: J6.4, R20.1, U9.26 (RUN)
SENSE_A: R1.1, U5.1 (COM), U7.3 (+)
SENSE_B: R2.1, U6.1 (COM), U7.5 (+)
SR_CHAIN_1: U1.9 (QH'), U2.14 (SER)
SR_CHAIN_2: U2.9 (QH'), U3.14 (SER)
SR_CHAIN_3: U3.9 (QH'), U4.14 (SER)
STATUS: R17.1, U9.37 (GPIO25)
SWCLK: J6.1, U9.24 (SWCLK)
SWDIO: J6.3, U9.25 (SWDIO)
SW_NODE: L2.1, U12.7 (SW)
SYNC_DE: R37.1, U9.17 (GPIO13), U11.3 (DE)
SYNC_N: J3.6, J4.6, R12.2, U11.7 (B)
SYNC_OUT: U9.15 (GPIO11), U11.1 (RO)
SYNC_P: J3.5, J4.5, R12.1, U11.6 (A)
USBC_D_N: D5.3 (I/O2), D5.4 (I/O2), J5.A7 (D-), J5.B7 (D-), R24.2
USBC_D_P: D5.1 (I/O1), D5.6 (I/O1), J5.A6 (D+), J5.B6 (D+), R23.2
USB_BUS_EN: R30.1, U9.36 (GPIO24), U14.3 (EN)
USB_BUS_SW: D4.2 (A), U14.6 (OUT)
USB_CC1: J5.A5 (CC1), U13.1 (CC1)
USB_CC2: J5.B5 (CC2), U13.2 (CC2)
USB_CC_OUT1: R32.1, U9.29 (GPIO18), U13.7 (SDA/OUT1)
USB_CC_OUT2: R33.1, U9.31 (GPIO19), U13.8 (SCL/OUT2)
USB_D_N: R24.1, U9.51 (USB_DM)
USB_D_P: R23.1, U9.52 (USB_DP)
USB_ILIM: R27.1, R28.1, U14.5 (ILIM)
USB_ILIM_HI: Q1.1 (G), R29.1, U9.2 (GPIO0)
USB_ILIM_LOW: Q1.3 (D), R28.2
USB_PWR_FAULT: R31.1, U9.35 (GPIO23), U14.4 (~FAULT)
USB_SNUB: C46.1, R38.2
USB_VBUS_DET: R34.2, U13.4 (VBUS_DET)
VCORE: C19.1, C24.1, C25.1, C35.1, L1.1, U9.6 (DVDD), U9.23 (DVDD), U9.39 (DVDD), U9.50 (VREG_FB)
VREG_AVDD: C16.1, C43.1, R35.2, U9.46 (VREG_AVDD)
VREG_LX: L1.2, U9.48 (VREG_LX)
XIN: C20.1, U9.21 (XIN), Y1.1
XOUT: C21.1, R36.2, Y1.3
XOUT_MCU: R36.1, U9.22 (XOUT)

Notes on the sheet:
TAXELSCAN / REV 4
32 x 32 matrix > two sense banks > RP2354A internal 12-bit ADC > RS-485 harness
01 ROW EXCITATION
MCU serial stream > four latched drivers > 32-way row FFC
02 COLUMN SENSING
32 columns > two 16:1 muxes > gain of 6 > filtered inputs to the MCU ADC
03 SCAN CONTROLLER
RP2354A / clock / core supply / local bypass
04 POWER + RAIL MONITOR
Harness or USB power > diode OR > local 3.3 V buck
05 COMMUNICATIONS + BOARD ADDRESS
Half-duplex data pair and dedicated receive-only sync pair
06 USB + PROGRAMMING
USB-C data / configuration straps / SWD / BOOTSEL
Rows 0-7
Rows 8-15
Rows 16-23
Rows 24-31
ROW FFC
Pin n = ROW_(n-1) Mounting pad = GND
Serial order: U1 > U2 > U3 > U4 Outputs enabled; unselected rows held LOW.
Clock / latch damping
U1-U4 bypass
Excitation rail link
COLUMN FFC
Pin n = COL_(n-1) Mounting pad = GND
R1/R2: 10k pulldown Rf/Rg: 10k / 2k (G = 6)
51R / 1nF at each MCU ADC pin Series resistors outside feedback
ADC_A > U9 GPIO27 / ADC1 (pin 41) ADC_B > U9 GPIO29 / ADC3 (pin 43)
The converter is the RP2354A (section 03). Its reference is ADC_AVDD, filtered off +3.3V by R26 / C36 (section 04); ROW_VCC is the same rail through R5, so the code stays ratiometric.
ROW_* > section 01 MUX_*, ADC_* > section 02 BUS_*, SYNC_* > section 05 USB_*, SWD* > section 06
Unused GPIO / stacked-flash pins are marked with no-connects.
R36: 1k XOUT series, limits crystal drive
12 MHz / C0G load capacitors
VREG_AVDD: 33R / 4.7uF filter
Core regulator / DVDD bypass
MCU 3.3 V bypass
3.3 V buck: TPS62162, fixed output 3-17 V in, 20 V absolute maximum
5 V rail monitor 100k / 47k divider to MCU
MCU ADC supply and reference filter
ROW_VCC link: section 01. ADC_AVDD is the ADC reference. All returns use GND.
DATA / half duplex
SYNC / master drives DE (GPIO13) R37 keeps other boards receive-only
R11 / R12: fit 120R only at the two harness ends.
HARNESS IN
HARNESS OUT
1 +5V 2 GND 3/4 DATA P/N 5/6 SYNC P/N
Board address straps: ADDR0 / ADDR1 / ADDR2 Closing a strap connects that input to GND.
Status indicator
CC1 / CC2 terminate inside U13 (section 07). Do not fit external 5.1k pulldowns.
D5: USB ESD, D+/D-/VBUS at the connector
SWD DEBUG
RUN pull-up
BOOTSEL: series resistor limits the flash-CS stub
USB series resistors at MCU end USB connector shell and all returns: GND
07 USB-C POWER TO THE HARNESS
Computer port current detection > firmware authorization > current limit > reverse barrier > +5V_BUS
UFP / sink only; ADDR left open selects GPIO mode. LAI variant required: OUT1/OUT2 track current changes.
R38 / C46: 0.68R + 22uF damps the hot-plug ring on +5V_USB
LOW limit: R27 only, about 0.32 A nominal HIGH limit: R27 || R28, about 0.63 A nominal D4 blocks an externally powered harness from USB.
POWER POLICY (GPIO 24 / 0 / 18 / 19 / 23)
Reset / no USB / fault: feed OFF. Default USB current: enable LOW only after USB configuration grants 500 mA. CC advertises 1.5 A or 3 A: HIGH permitted. Fewer boards draw less; limits do not force current. Firmware must service CC changes promptly, disable on default-current suspend/reset, and lat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
POWER-NET DRIVE DECLARATIONS
Reading the sheet
Matching net labels connect between sections. A dot marks a branch; an X marks an unused pin. Bypass capacitors are grouped by supply. USB attach current and the complete eight-board startup / operating budget require measurements; schematic checks cannot establish them.
Sensor path: ROW_n > mat element > COL_n > SENSE_A/B > AMP_A/B > ADC_A/B
R1/R2 and gain-network values remain fit-on-test values from the existing design.

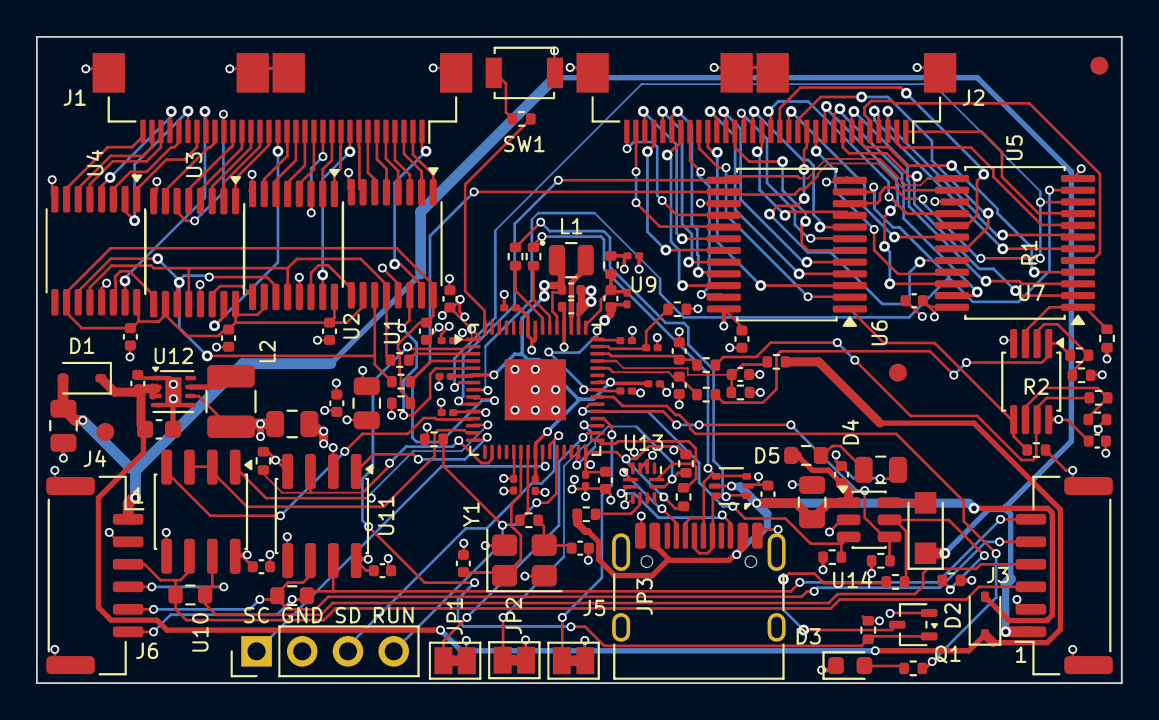
[picture p25: board rev4.kicad_pcb from above]

Board: 4 copper layers, 60.3 x 35.9 mm, 110 parts (0 on the bottom side), 134 nets.

Other parts of the board:
FID1, FID2, FID3: Fiducial; Fiducial_1mm_Mask2mm
