MLeggiero/taxelscan/boards/fork-adapter/fork-adapter.kicad_pcb

## KiCad design boards/fork-adapter/fork-adapter.kicad_pcb (2026-08-23)

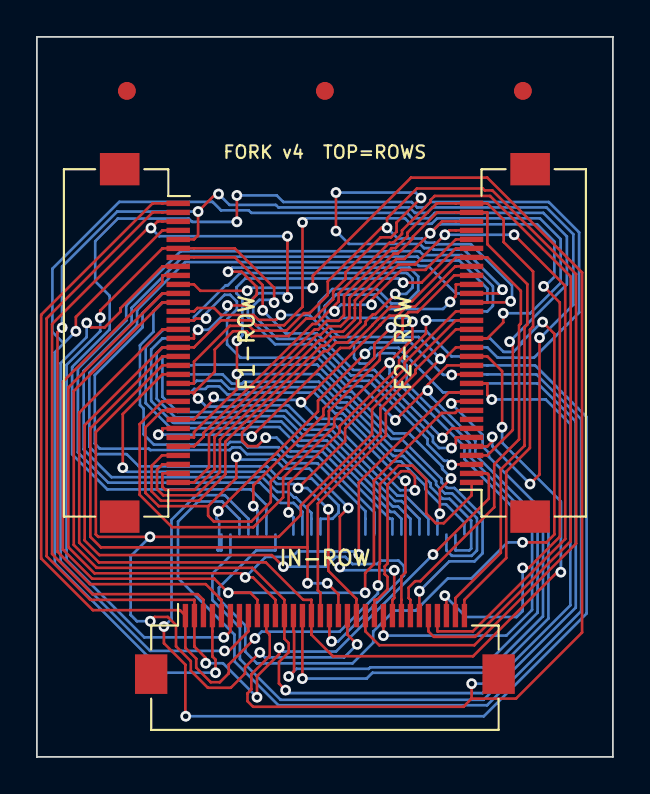
[picture p26: board fork-adapter.kicad_pcb from above]

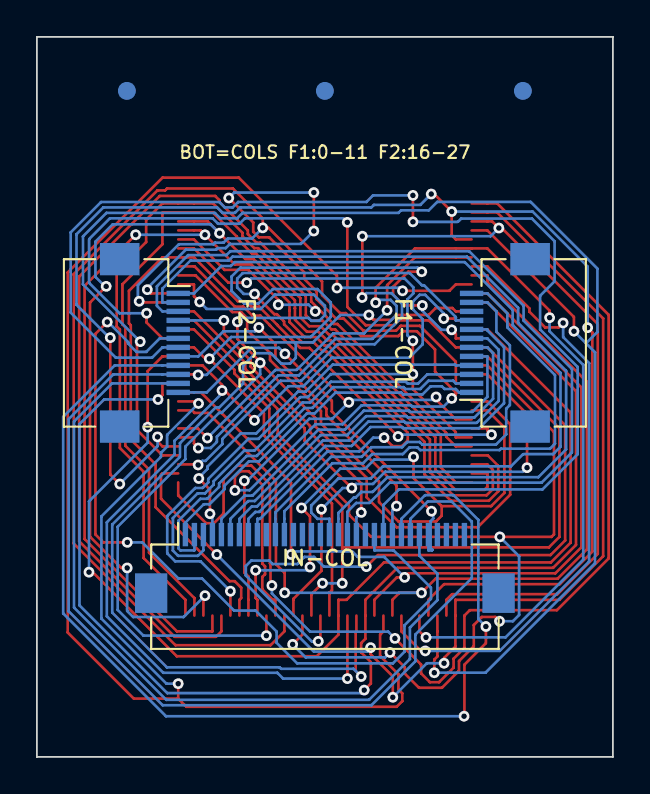
[picture p27: board fork-adapter.kicad_pcb from below]

Board: 2 copper layers, 32.0 x 40.0 mm, 12 parts (6 on the bottom side), 56 nets.

Parts:
FID1B, FID1T, FID2B, FID2T, FID3B, FID3T: Fiducial_1mm_Mask2mm
J1, J2, J3, J4: Hirose_FH12-32S-0.5SH_1x32-1MP_P0.50mm_Horizontal
J5, J6: Hirose_FH12-12S-0.5SH_1x12-1MP_P0.50mm_Horizontal

Connections:
COL_0: J2.1, J5.1
COL_1: J2.2, J5.2
COL_2: J2.3, J5.3
COL_3: J2.4, J5.4
COL_4: J2.5, J5.5
COL_5: J2.6, J5.6
COL_6: J2.7, J5.7
COL_7: J2.8, J5.8
COL_8: J2.9, J5.9
COL_9: J2.10, J5.10
COL_10: J2.11, J5.11
COL_11: J2.12, J5.12
COL_16: J2.17, J6.1
COL_17: J2.18, J6.2
COL_18: J2.19, J6.3
COL_19: J2.20, J6.4
COL_20: J2.21, J6.5
COL_21: J2.22, J6.6
COL_22: J2.23, J6.7
COL_23: J2.24, J6.8
COL_24: J2.25, J6.9
COL_25: J2.26, J6.10
COL_26: J2.27, J6.11
COL_27: J2.28, J6.12
ROW_0: J1.1, J3.1, J4.1
ROW_1: J1.2, J3.2, J4.2
ROW_2: J1.3, J3.3, J4.3
ROW_3: J1.4, J3.4, J4.4
ROW_4: J1.5, J3.5, J4.5
ROW_5: J1.6, J3.6, J4.6
ROW_6: J1.7, J3.7, J4.7
ROW_7: J1.8, J3.8, J4.8
ROW_8: J1.9, J3.9, J4.9
ROW_9: J1.10, J3.10, J4.10
ROW_10: J1.11, J3.11, J4.11
ROW_11: J1.12, J3.12, J4.12
ROW_12: J1.13, J3.13, J4.13
ROW_13: J1.14, J3.14, J4.14
ROW_14: J1.15, J3.15, J4.15
ROW_15: J1.16, J3.16, J4.16
ROW_16: J1.17, J3.17, J4.17
ROW_17: J1.18, J3.18, J4.18
ROW_18: J1.19, J3.19, J4.19
ROW_19: J1.20, J3.20, J4.20
ROW_20: J1.21, J3.21, J4.21
ROW_21: J1.22, J3.22, J4.22
ROW_22: J1.23, J3.23, J4.23
ROW_23: J1.24, J3.24, J4.24
ROW_24: J1.25, J3.25, J4.25
ROW_25: J1.26, J3.26, J4.26
ROW_26: J1.27, J3.27, J4.27
ROW_27: J1.28, J3.28, J4.28
ROW_28: J1.29, J3.29, J4.29
ROW_29: J1.30, J3.30, J4.30
ROW_30: J1.31, J3.31, J4.31
ROW_31: J1.32, J3.32, J4.32
