MLeggiero/taxelscan/boards/rev4/tools/preroute_rev4.py

"""preroute_rev4.py in.kicad_pcb out.kicad_pcb - the nets routed before freerouting.

Freerouting has one clearance per net class and no rule areas, so it cannot use
U9_escape's 0.10 mm, and it knows nothing of pairs or of how a regulator has to
be laid out. The nets that need any of that are laid here first, on the
stripped board (every signal off, the planes' ties kept - fix_rev4.py drew the
regulator's and the buck's GND / +3.3 V copper), by the same exact-geometry
model and octilinear router as everything else; dsn_prep.py --fixed then hands
them to freerouting as copper it must route around. In this order:

  - the RP2354A's core regulator, drawn as the RP2350 datasheet's Figure 26
    and Raspberry Pi's RP2350A minimal design (vreg): VREG_LX from pin 48
    straight up between CIN's (C44) and COUT's (C19) pads into L1, on F.Cu
    with no via, 0.2 mm off the pin and 0.3 mm on; VCORE's regulator end - L1's dot pad to COUT, and down
    through two vias west of COUT - and VREG_FB from COUT's pad back to pin 50,
    clear of LX; VREG_AVDD from pin 46 to CFILT (C43), the 33 R (R35) and
    C16. Then SW_NODE, the buck converter's: the TPS62162's switch pin to L2
    on F.Cu, 0.3 mm, no via; and the buck's +5 V input at the pins - C27
    across VIN / PGND, EN tied to VIN, on to C22 - which freerouting joins to
    D1 and D2 (fr_finish.py keeps it as laid)
  - USB_D_P / USB_D_N, the RP2354A's USB pins to the 27-ohm series resistors
    R23 / R24, north-west on F.Cu beside VREG_FB as the minimal design runs
    them; pins 51 and 52 are 0.4 mm apart in U9_escape, which freerouting's
    0.15 mm clearance leaves no way out of
  - the ADC corner: ADC_B, RAIL_MON and ADC_A out of the RP2354A's pins 43, 42
    and 41, drawn (fr_finish.CORNER); then RAIL_MON's other end, C45 to the
    divider R15 / R16, by rr3
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
