MLeggiero/taxelscan/(commit log)

2026-08-25 sim: portable build, and measure the fixed-point one-euro question
    Groundwork for the 8-sensor redesign, where the conditioning pipeline has to
    fit 8192 taxels into a 10 ms frame instead of 512 into 12.5 ms.
    Adds a Makefile alongside build.cmd so condition.cpp can be exercised on
    Linux/macOS as well as MSVC, and a tools/armcycles.sh that cross-compiles it
    for Cortex-M33 and M7 and attributes each instruction back to its source line.
    x86 timings answer "did the behaviour change"; they cannot answer "is this
    faster on the board", because x86 has a fast pipelined FP divider and
    Cortex-M does not.
    The first thing measured was the plan's headline optimisation: replace the
    per-taxel VDIV.F32 in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
    [condition.cpp, condition.h]
2026-08-25 tools: per-stage cost of condProcess on the target core
    The one-euro measurement raised the obvious follow-up: if that stage is not
    where the cycles are, where are they? This groups the same DWARF attribution
    by the stage markers in condProcess() and totals each.
    Consistent on both cores (share of the per-taxel total):
    stage M7 M33
    10 connected components 33.8% 34.9%
    5 adaptive baseline 18.9% 20.7%
    7+8 threshold/debounce 16.9% 13.6%
    9 despeckle 11.9% 12.5%
    6 one-euro 8.4% 8.6%
    release eligibility 8.1% 7.8%
    4 median-of-3 2.0% 1.8%
    So the one-euro was never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
2026-08-25 tools: measure per-taxel RAM instead of counting it by hand
    Reads the array sizes out of the compiled ARM object and classifies each by
    how it was declared, which is how you avoid missing a 2 KB scratch buffer
    hidden inside a function or crediting a saving to an array that was never
    per-taxel.
    The pipeline is exactly 55.00 B/taxel: 47 across 20 per-taxel arrays in
    condition.cpp, 8 in scan.cpp for rawFrame + drFrame + drBuf[2]. At 8192 taxels
    that is 440 KB against the 512 KB of contiguous AXI SRAM on an STM32H743, so
    the 8-sensor state fits with 72 KB spare and none of the planned trimming is
    needed to get there. It stays available as headroom.
    The distinction the tool exists to enforce is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
    [armmemory.py]
2026-08-26 sim: a golden digest that can actually fail
    Prerequisite for the activity-bitmap rewrite, which is a pure representation
    change and so must produce byte-identical output. `make regress` compares the
    per-frame digest against golden/digest.csv with zero tolerance on every field.
    The first version of this was worthless and it is worth saying why, because the
    failure mode is quiet. Its scene pressed one blob in the middle of the mat and
    watched it decay. Injecting the exact off-by-one a bitmap rewrite produces -
    `c < nc - 1` becoming `c < nc - 2` in the despeckle neighbour test - changed
    nothing in the digest, and all 18 A-G checks still passed. A test that cannot
    fail is worse than no test, be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
    [digest.csv]
2026-08-26 condition: activity as one bit per taxel, one word per row
    MAX_COLS is exactly 32, so a row's activity is exactly one uint32. That is what
    makes this worth doing: connected components, despeckle and release eligibility
    were 53.8% of the per-taxel budget between them, plus the halo inside the
    baseline stage, and all four spent it on bounds-checked per-taxel neighbour
    tests. In word form a neighbourhood is a shift and an OR.
    The bounds checks do not get reimplemented, they disappear. Shifting brings in
    zeros at the ends, which is exactly "outside the array is not active" - so the
    halo's nine-way scan becomes a 3x3 dilation computed once per frame and read
    with one bit test, despeckle becomes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
2026-08-26 condition: condition eight mats, one at a time
    The pipeline now runs per mat. condProcess() does the work that belongs to the
    frame - the dt clamp, the median history, the baseline rate budgets - and hands
    those to condProcessOne() once for each enabled sensor. Nothing about the
    pipeline body changed: it addresses one mat, indexed from that mat's base, and
    a local alias binds this mat's rows of activity state so the body reads exactly
    as it did.
    Arrays are split by whether they SCALE with sensor count, and the split is
    load-bearing rather than cosmetic:
    [MAX_ALL_TAXELS] persistent per-taxel state, 40 B/taxel
    [MAX_TAXELS] per-mat scratch: label, and condTareOut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
    [armmemory.py, condition.cpp, condition.h, protocol.cpp, scan.h, taxelscan.ino]
2026-08-27 board-v2: the front-end module, derived from the proven netlist
    First hardware for the 8-mat reader. One module sits at each mat and is the
    rev-1 board with the MCU removed and a cable put in its place - same drivers,
    same muxes, same buffer, same footprints - so there is no new analog to
    validate, only new wiring, and it can be bench-tested against a XIAO running
    rev-1 firmware before the hub exists.
    module.net is generated rather than drawn. gen_module.py transforms rev-1's
    exported netlist and applies the deltas longhand. For a circuit already
    measured on hardware that beats retyping pin numbers out of datasheets: every
    row driver, mux and buffer connection here is the one that was measu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
    [BOM.csv]
2026-08-27 board-v2: the module schematic, checked by KiCad itself
    module.kicad_sch is generated by transforming rev-1's schematic rather than
    redrawing it, so every 595, mux and buffer keeps the position, orientation and
    labels it was verified with, and the diff is the change rather than the whole
    sheet. rev-1 turns out to have been produced by a generator itself
    (generator "flexitac_gen"), so this fits the existing workflow.
    Written in KiCad 7 format deliberately. kiutils writes that natively,
    kicad-cli 7 can then load it and export a netlist, and KiCad 10 opens and
    upgrades it on the way in. Emitting v10 directly would have meant nothing in
    this toolchain could check it.
    Power symbols become globa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
    [module.kicad_sch]
2026-08-28 repo: one directory per board, one copy of each shared library
    The repository had grown a fourth board while still laying out as though it had
    one: board/, fork-adapter/ and board-v2/module/ at top level, with board/ also
    serving as the library store for anything else that needed FlexiTac.
    boards/rev1/ the shipped single-sensor reader
    boards/fork-adapter/ passive two-finger adapter
    boards/v2-module/ front-end module for the 8-mat reader
    boards/v2-hub/ not started; README says what it will be
    libraries/ FlexiTac, Snapeda, Samacsys - shared
    Moved with git mv so history follows the files. KiCad's library tables use
    ${KIPRJMOD}, so re-po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
    [BOM.csv, BOM_final.csv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]
2026-09-21 rev3 board
    [BOM.csv, module.kicad_pcb, module.kicad_sch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]
2026-10-04 firmware/rev3_power: rev-4 pin map for the TUSB320 status lines
    rev-4 (boards/rev4) reads both sense banks on the RP2354A's internal ADC,
    so GPIO27 and GPIO29 become ADC inputs and USB_CC_OUT1/OUT2 move to
    GPIO18/19, the pins rev-3's SPI bus to the LTC1865L used.
    TAXELSCAN_BOARD_REV selects the map (default 3, rev-3 unchanged), and the
    native policy test now checks both maps at compile time.
    Claude-Session: https://claude.ai/code/session_01Jwb4Me1PRQy3veDA1j4mJ1
2026-10-04 boards/rev4: rev-3 without the external ADC, re-placed and routed
    rev-4 is rev-3 with the LTC1865L 16-bit converter and the parts that served
    only it removed (U8, C8, R10, C10, C26). Both sense banks are read by the
    RP2354A's own 12-bit ADC: bank A on GPIO27/ADC1, bank B on GPIO29/ADC3,
    RAIL_MON stays on GPIO28/ADC2, and the TUSB320 status lines move to
    GPIO18/19, the pins rev-3's SPI bus used.
    - gen_rev4.py / check_faults.py: netlist and BOM derived like rev-3's, with
    the converter checks rewritten for the internal ADC; 135 of 135 nets, 39
    injected faults all caught.
    - rev4.kicad_sch: regenerated, 135 of 135 nets match, ERC 0 errors.
    - rev4.kicad_pcb: rev-3's routed board with the five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
    [BOM.csv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]
2026-10-04 boards/rev4: re-route from scratch with straight 0/45/90-degree routing
    rev-4 kept rev-3's routing wherever the ADC change did not reach, and 67 % of
    that copper (1575 of 2348 mm) ran at arbitrary angles. Every signal is now
    re-routed: 5.7 of 2394 mm (0.2 %) is off the 45-degree grid, all of it in the
    GND / +3.3 V pad-to-via ties; segments under 0.1 mm 675 -> 85, corners
    1745 -> 986, vias 336 -> 324. Placement is unchanged to the nanometre, so the
    BOM and CPL are identical.
    How (tools/freeroute_rev4.py, documented in ROUTING_STATUS.md):
    - pre-route on the stripped board with the exact-geometry router, octilinear
    (new rr3.py / grid_route3.cpp): VREG_LX, USB_D, the ADC corner, VCORE at
    0.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
    [rev4-B_Cu.gbr, rev4-B_Mask.gbr, rev4-B_Paste.gbr, rev4-B_Silkscreen.gbr, rev4-Edge_Cuts.gbr, rev4-F_Cu.gbr, rev4-F_Mask.gbr, rev4-F_Paste.gbr]
2026-10-05 boards/rev4: pre-route the USB-C data lines as a pair
    USBC_D_P / USBC_D_N (J5 through the ESD array D5 to R23 / R24) were left to
    Freerouting in the first re-route: 33.0 / 22.0 mm, 6 / 4 vias, not coupled.
    preroute_rev4.py now lays them before Freerouting runs: J5's interleaved data
    pins are bridged in pairs (D- over the pin row, D+ under it), the lines pass
    through D5 pin to pin, and the long run goes side by side on B.Cu. Result:
    23.7 / 18.6 mm, 2 / 2 vias, 42 % coupled, 5.1 mm skew.
    The pair needed four more pieces of pre-laid copper:
    - SW_NODE on F.Cu with no via, like VREG_LX (one run sent it through two).
    - D5.5 (VBUS): a via in the middle of D5's body and a B.Cu tie to C38. The
    pad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
    [rev4-B_Cu.gbr, rev4-B_Mask.gbr, rev4-B_Paste.gbr, rev4-B_Silkscreen.gbr, rev4-Edge_Cuts.gbr, rev4-F_Cu.gbr, rev4-F_Mask.gbr, rev4-F_Paste.gbr]
2026-10-05 boards/rev4: functional verification against the datasheets
    Checked whether the committed board works as built:
    - every IC pin by pin against its datasheet;
    - the analog chain on the internal ADC and the USB hot plug in ngspice;
    - the routed copper measured on the board;
    - the project's own checks re-run.
    The circuit is correct and complete. The netlist is rev-3's audited
    circuit with only the intended ADC changes. DRC, ERC, parity,
    gen_rev4.py (135/135), check_faults.py (40/40) and the power-policy
    tests pass.
    Found, all inherited from rev-3:
    - The RP2354A core-regulator layout departs from RP2350 datasheet
    section 6.3.8 / Fig. 26: CIN and COUT sit 5.7-5.9 mm from the pins,
    and the sw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
2026-10-08 boards/rev4: verification fixes, work in progress (board not re-routed)
    Saved before the re-route is finished. rev4.kicad_pcb and fab/ are still
    the 5 October board. They do not match rev4.net, rev4.kicad_sch and
    BOM.csv, which already carry the changes below, so schematic parity fails
    until the new board is installed. README.md, VERIFICATION.md and
    ROUTING_STATUS.md still carry @...@ placeholders for numbers not yet
    measured.
    Done (VERIFICATION.md findings 1-3, 10, 11):
    - Core regulator: tools/fix_rev4.py places CIN, COUT, L1, CFILT and their
    neighbours at the RP2350A minimal design's offsets from U9 pin 48. CIN
    and COUT are 0402 on a wide-gap land
    (FlexiTac:C_0402_1005Metric_WideGap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
    [BOM.csv, rev4.kicad_sch]
2026-10-08 boards/rev4: draw the corner south-east of U9 in the pre-route
    Still work in progress: the board is not re-routed yet (see 08a5a95).
    With J6 in Raspberry Pi's order, the corner south and east of the RP2354A
    was more than Freerouting and the rip-up loop could finish. Its parts have
    not moved since 7ca63a4, so preroute_rev4.py now draws ADDR0-2 and
    USB_CC_OUT1 after that board's routing, straightened (SOUTH_EAST): the
    address lines drop to B.Cu in U9's pin ring and run to the jumpers side by
    side; USB_CC_OUT1 drops under pin 29 and crosses under the east pin row.
    rr3 then lays the TUSB320's other nets (USB_CC_OUT2, USB_VBUS_DET, USB_CC2,
    USB_CC1) and SWCLK / SWDIO / RUN. Searched one net at a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
2026-10-08 boards/rev4: install the re-routed board
    The third re-route, on the 7 October placement (tools/fix_rev4.py), with
    30 nets pre-routed. KiCad 10.0.6 DRC with zones refilled: 0 unconnected,
    0 copper violations, rev-3's 5 silkscreen warnings. Schematic parity: 199
    items, all the '/' name prefix or J5's open SBU pins.
    fab/ and the documents are regenerated in the next commit.
    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
    [rev4.kicad_pcb]
2026-10-08 boards/rev4: regenerate fab/ and the renders for the re-routed board
    make_fab.py on the installed board: gerbers, drills, BOM and CPL sets
    (102 parts on a middle board, 104 on an end board; R18 / R19 gone), the
    drawings and order notes. The renders show the new routing.
    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
    [rev4-B_Cu.gbr, rev4-B_Mask.gbr, rev4-B_Paste.gbr, rev4-B_Silkscreen.gbr, rev4-Edge_Cuts.gbr, rev4-F_Cu.gbr, rev4-F_Mask.gbr, rev4-F_Paste.gbr]
2026-10-08 boards/rev4: widen the 5 V rails where they fit
    fr_finish.py's widening now also takes +5V_BUS (the harness pass-through)
    to 0.60 / 0.50 / 0.40 mm and +5V / +5V_USB to 0.50 / 0.40 mm wherever the
    exact check allows: 60 tracks, 108 mm. Run on the installed board with
    --tidy-only; tidy found nothing more. The pass-through J4.1 -> J3.1 goes
    from 162 to 134 mOhm. DRC and parity pass as before.
    verify/layout/powerpath.py names the TPS62162's VIN (pin 2) and SW (pin 7).
    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
    [rev4.kicad_pcb]
2026-10-08 boards/rev4: ROUTING_STATUS.md for the third re-route
    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
2026-10-08 boards/rev4: README numbers for the re-routed board
    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
2026-10-08 boards/rev4: VERIFICATION.md re-checked on the re-routed board
    The status of findings 1-4, 10 and 11 with the numbers measured on the
    8 October board, the layout section re-measured, and three small new
    items from the re-route (15-17): U13's VDD bypass now through the plane,
    the harness pass-through at 134 mOhm, one via 0.41 mm from J5's peg hole.
    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
2026-10-08 boards/rev4: regenerate fab/ and the renders for the widened board
    The fab package and the renders now come from the installed board, after the
    5 V widening. STACKUP-NOTES gives this board's via-in-pad count: 107 (11
    wholly, 96 partly; 26 one-pad passives).
    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
    [rev4-B_Cu.gbr, rev4-B_Mask.gbr, rev4-B_Paste.gbr, rev4-B_Silkscreen.gbr, rev4-Edge_Cuts.gbr, rev4-F_Cu.gbr, rev4-F_Mask.gbr, rev4-F_Paste.gbr]
2026-10-08 boards/rev4: PLACEMENT.md counts and tools/README.md for the re-route
    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
2026-10-08 README: describe the rev-4 board
    The top-level README now describes TaxelScan v4 (boards/rev4) as it stands:
    the internal 12-bit ADC, its signal chain, timing, harness, power and build
    numbers, the checks and the open items, with plan-view renders of the
    rev-4 board (assets/taxelscan-v4-top.png, -bottom.png).
    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
2026-10-17 boards/rev4: give U9 a QFN-60 3D model that matches its pads
    KiCad ships no model for QFN-60-1EP_7x7mm_P0.4mm_EP3.4x3.4mm. Rev-3 borrowed
    KiCad's QFN-56 7x7 body, which has 14 leads a side against the footprint's 15
    pads, so in the 3D viewer every lead sat between two pads.
    libraries/TaxelScan.3dshapes/make_qfn60.py draws the package from the RP2350
    datasheet's drawing (Fig. 147) as a STEP model, using nothing beyond Python.
    U9 points at it through ${KIPRJMOD}. Only that model path changes in the
    board: DRC and schematic parity are identical before and after. The README's
    top render is regenerated.
    Claude-Session: https://claude.ai/co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
2026-10-21 boards/rev4: tools for the 21 October design review
    review_rev4.py makes the layout changes for the review's comments that hold,
    on the routed board, in stages: four parts moved in from the edge; the plane
    vias moved out of the SMD pad openings, with signal nets in the way taken up
    and routed again; the 0.10 mm signal track away from the fine-pitch pins
    routed again or widened; the bare right-angle corners cut to two 45-degree
    bends. Every segment and via it adds is checked exactly. At the end it takes
    off segments doubled along another of their net and anything KiCad's own
    connectivity still calls dangling, where the net stays whole.
    verify/layout/review.py measures the six comments on a b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
2026-10-21 boards/rev4: review_rev4.py checks moved plane vias against the fill
    The exact-geometry checks know nothing of zone fills, so a via moved into a
    through-hole pad's thermal-relief gap passes them and reaches no plane: J5.B12's
    ground via did, beside the USB-C receptacle's shield pin. The via stage now
    fills the planes with KiCad's own filler at its end and moves any plane via
    whose centre is outside its plane's fill to a place where its whole land is
    in it; --stages planes runs the check alone.
    Claude-Session: https://claude.ai/code/session_01Kwp4BucfqHomW3o8thdpmP
2026-10-21 boards/rev4: the design review's layout changes
    An experienced electrical engineer's six comments on the routed board,
    measured in REVIEW.md; tools/review_rev4.py made the changes for the ones
    that hold, from 050e8a4's board:
    - C39, R1, R17 and D3 moved in from the outline, to 0.50-0.75 mm (they had
    copper 0.27-0.37 mm from it), and the copper-to-edge rule is 0.40 mm,
    JLCPCB's V-cut figure.
    - 97 of the 98 plane vias whose holes were in SMD pad openings moved out (or
    were taken off, their pads tied to a neighbour's via): no two-pad passive
    has a hole at one pad any more. U5 pin 15's stays, with the exposed pads'.
    - The 0.10 mm signal track away from the fine-pitch pins was routed aga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
2026-10-21 boards/rev4: regenerate fab/ and the renders after the design review
    The order notes now ask for tented vias: no via hole is in an SMD pad's
    mask opening, or within 0.10 mm of one, but the 9 in U9's and U12's exposed
    pads and U5 pin 15's, so epoxy-filled, capped vias are optional, and only
    help those. The CPLs move C39, R1, R17 and D3; the BOMs are unchanged; 300
    via drills for 300 vias. pcb_top.png is the bare board, as before, and the
    two README renders show the parts.
    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
2026-10-21 boards/rev4: REVIEW.md, and the docs brought up to the reviewed board
    REVIEW.md takes the six comments one by one: what each claims, what the
    board measured (verify/layout/review.py), whether it holds here and why,
    what changed and what was left, with JLCPCB's published rules and the
    signals' real edge rates. In short: vias in pads and parts at the edge held
    and are fixed; the width changes were real (and broke the board's own rule)
    though harmless at these lengths, and are mostly gone; the right angles cost
    under 1 ps and are cut anyway; the bottom-layer fast nets are where pin order
    puts them, and routing them again found little better; the 3.3 V tracks were
    fine.
    ROUTING_STATUS.md, VERIF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
2026-10-23 boards/rev4: correct the CPLs for JLCPCB's own footprints
    JLCPCB places each LCSC part's own (EasyEDA) footprint at the CPL's position
    and rotation, and the CPLs carried KiCad's numbers unchanged. Placed that way,
    14 parts landed 1.6-8.5 mm off their pads: the 595s, the 4067s, the op-amp
    and the RS-485 transceivers turned 90 degrees, U14, D5 and Q1 turned over,
    the SWD header turned and moved, the USB-C receptacle 1.6 mm out.
    tools/jlc_placement.py fetches each LCSC part's footprint, matches its pads to
    KiCad's by number and fits the rotation and origin offset between the two
    (jlc_placement.csv; no generic package table, which would have turned U9
    wrongly). make_fab.py applies it and refuse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
2026-10-23 boards/rev4: order notes with today's JLCPCB stock
    Every BOM line checked against JLCPCB's assembly stock on 23 October: the
    FFC connectors J1/J2 now limit an order to 9 boards (18 left, 2 per board),
    then L1 (30) and J6 (46). D1/D2, the limit on 28 September, are restocked.
    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
2026-10-26 boards/rev4: order notes: L1 is out of stock
    JLCPCB has one AOTA-B201610S3R3-101-T left (30 on 23 October) and LCSC none,
    so L1 now limits an assembled order to one board. It is the RP2350 design
    guide's only recommended inductor, so the notes say how to source that exact
    part rather than substitute it.
    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
2026-10-26 boards/rev4: take U5 pin 15's via out of its pad
    The design review left one via hole in an SMD pad besides the exposed
    pads': U5 pin 15's ground via (bank A's mux enable, tied low), centred on
    the toe of the pad with half its hole under the paste. The hole holds about
    twice the solder that pad gets, so the joint could starve, and with that
    pin open bank A reads nothing. The via is boxed in by MUX_S0's via and the
    column lines, so the pad moves instead: a new last stage of
    review_rev4.py, toe, cuts the pad back 0.30 mm at its outer end (1.60 mm,
    the other pins 1.90). The hole is now 0.15 mm clear of the opening and
    tented, the tie still runs 0.6 mm into the pad, and the lead still lands
    on it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
2026-10-26 boards/rev4: routing, vias and a lower-resistance mat, checked again
    Three new checks, each first shown to catch a planted fault:
    - verify/layout/copper.py: connectivity, shorts and spacing from the
    copper shapes alone (shapely, not KiCad's DRC or connectivity), every
    pad's net against rev4.net. 134 nets whole, nothing touching, spacing at
    or above the rules, holes 0.25 mm from other copper.
    - verify/layout/etest.py: a bare-board e-test of the Gerbers and drill
    files themselves, rendered by gerbv at 10 um, against rev4.net. 522 pads,
    0 opens, 0 shorts but the bridged ADDR jumpers, no stray copper.
    - verify/layout/vias.py: every via's layers, plane landing, tenting and
    paste over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
2026-10-28 boards/rev4: fab package with Protel extensions and today's stock
    JLCPCB's KiCad guides ask for Protel filename extensions ("JLCPCB prefers
    Protel filename extensions"). make_fab.py exported plain .gbr, so the
    inner layers went up as rev4-GND.gbr and rev4-PWR.gbr, named after the
    board's own layer names, with only the X2 attributes to say which inner
    layer each is. Now they are rev4-GND.g1 and rev4-PWR.g2, G1 / G2 being
    Protel's first and second inner layers, and every other layer has its
    Protel extension too. The content of every file is unchanged, dates
    aside.
    make_fab.py's plane check now reads each Gerber's %TF.FileFunction
    instead of its name, and checks that the 11 layers JLCPCB needs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
